bernardopg/ps28-modern-amp/kicad/core-oem-refined/README.md

# Candidata OEM refinada — STUDY ONLY

Estudo separado das revisões B/C, não aprovação mecânica/elétrica ou de fabricação.
Contorno153×79,1mm inferido do painel de cobre; escala vertical, borda real e mapa
completo de montagem não verificados. Reservas conservadoras9×9mm nas quatro
camadas, sem transformar features ambíguas em furos. J6 é bond GND por trança,
sem novo mounting point. Reutilizar somente fixações/suportes/dissipadores OEM.

47 footprints/142 pads; DRC nativo0 geometria/0 paridade/109 não roteadas;
ERC4 conflitos não excluídos. Ainda faltam fonte, controle, front-end e proteção.
Ver `docs/functional-readiness.md` e `tests/reports/core-oem-refined-review.json`.
O gerador recusa sobrescrever; não regenerar sobre projeto editado/roteado.
