bernardopg/ps28-modern-amp/kicad/core-oem/README.md

# OEM-referenced core C STUDY

Reconstructed scale/placement, NOT manufacturing approval.
Original B preserved. See ../../mechanical/original-board-reference.md and oem-reconstruction.json.
No inferred holes; ambiguous features reserved. Actual edge/right strip and vertical scale unresolved.
