bernardopg/ps28-modern-amp/kicad/core-selected/README.md

# Core B — seleção e placement

47 componentes/footprints; consultar ../../docs/selected-core.md.
Sem fit medido, sem roteamento e sem fabricação autorizada.
MPNs são seleção de engenharia, sem estoque/compra/lifecycle aprovados.
