bernardopg/ps28-modern-amp/docs/images/kicad-3d/README.md

# Renders KiCad

Vistas nativas de `kicad-cli pcb render` (KiCad 10, qualidade alta) da placa
`kicad/system-candidate/`. Pillow só aplica o fundo grafite e monta o GIF.
Para a apresentação de produto, ver os [renders Blender](../pcb-studio/README.md).

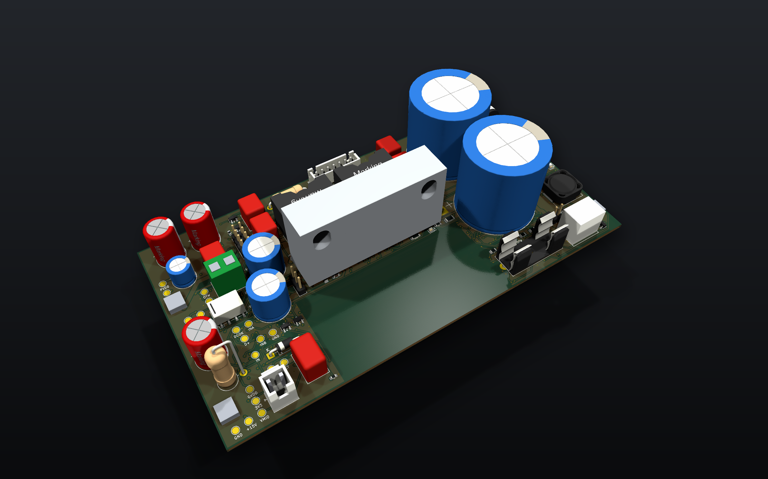
[picture p4: docs/images/kicad-3d/system-isometric.png]
Isométrica


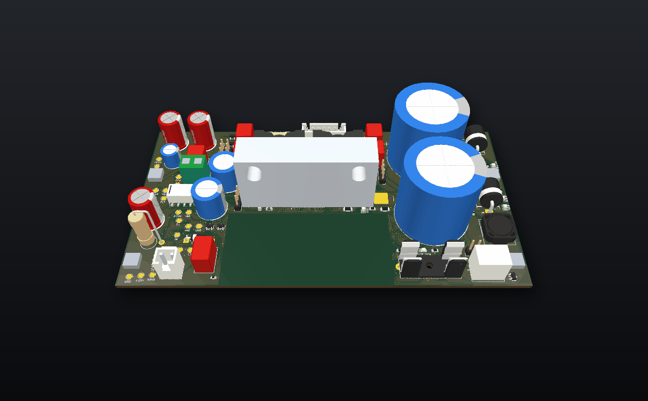
[picture p5: docs/images/kicad-3d/system-orbit.gif]
Órbita


| Topo | Verso |
|---|---|
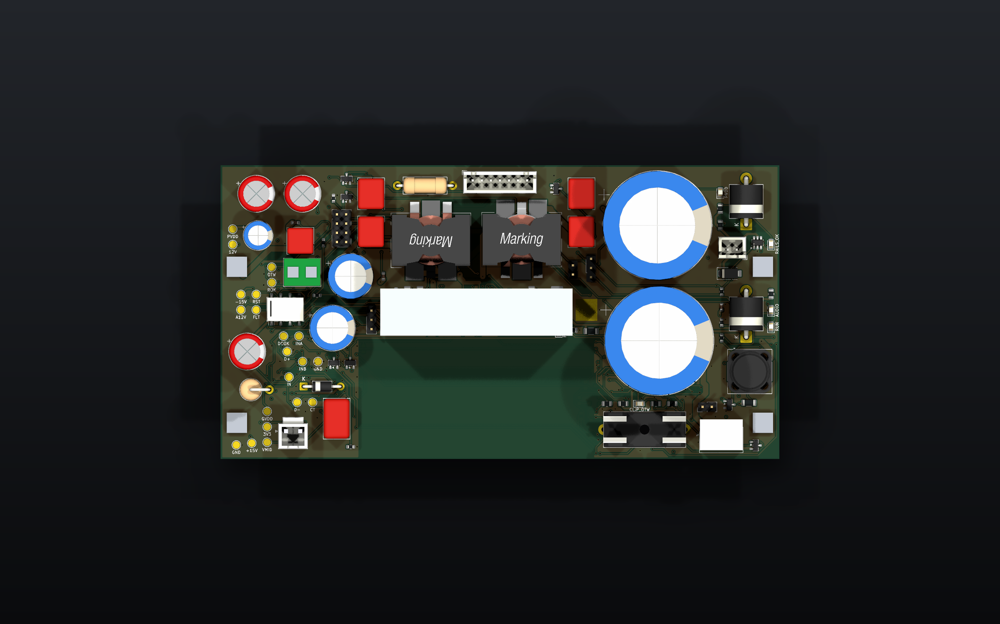
[picture p6: docs/images/kicad-3d/system-top.png]
Topo
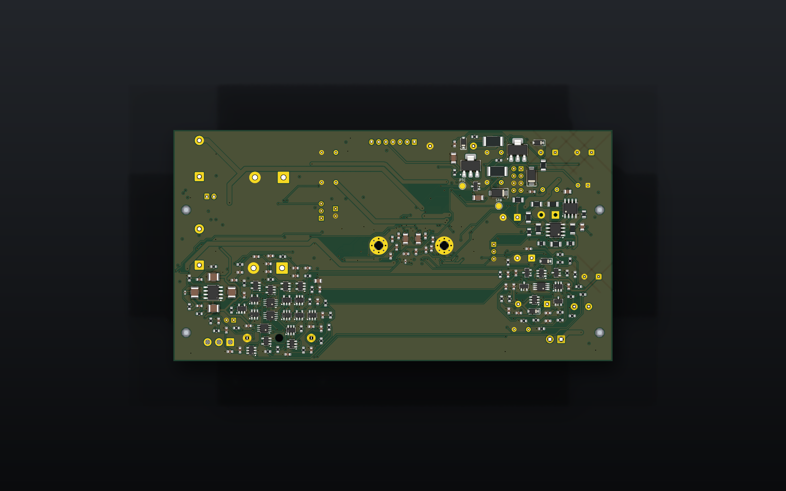
[picture p7: docs/images/kicad-3d/system-bottom.png]
Verso
|  |  |

Modelos de catálogo KiCad (cores genéricas). Sem modelo 3D: test pads, J6 e H6
(o bloco térmico usa o modelo de H5); lista no [manifesto](manifest.json).

Regenerar: `make render-3d`.
