bernardopg/ps28-modern-amp/docs/images/system-candidate/README.md

# Esquema da placa

[Esquema completo em SVG](system-candidate.svg), exportado do `.kicad_sch` de
`kicad/system-candidate/`. Estado de liberação em [status.md](../../status.md).

Regenerar:

```sh
kicad-cli sch export svg --output build/system-svg/ kicad/system-candidate/system-candidate.kicad_sch
```
