bernardopg/ps28-modern-amp/docs/images/.ps28-gallery-q9vnf0af/README.md

# Arquivo de renderização interrompida — não usar como galeria atual

Imagens parciais remanescentes de uma execução interrompida de 2026-10-13,
preservadas na consolidação de todo o diff a pedido do proprietário.
Não possuem manifesto completo dessa execução e não representam o estado
elétrico/mecânico atual. Não substituir os renders atuais por estes arquivos.

Galeria atual com manifesto: [../kicad-3d/README.md](../kicad-3d/README.md).
