bernardopg/ps28-modern-amp/docs/images/analog-protected/README.md

# Exportações nativas KiCad — D-018
PDF e SVG exportados por `kicad-cli sch export pdf` e
`kicad-cli sch export svg` de
`kicad/analog-protected/analog-protected.kicad_sch`.
32 componentes/80 pinos/ERC0, candidata sob envelope; não fabricação/energização.
Essas imagens NÃO são render3D nem PCB roteada. A galeria3D anterior permanece
válida para os mesmos arquivos de PCB, que não foram alterados.
Ver `docs/vmid-protection.md` para limitações físicas/power-order/interfaces.
