bernardopg/ps28-modern-amp/12_REFERENCES.md

# Referências oficiais e técnicas

## Texas Instruments

### TPA3255

- Product page: https://www.ti.com/product/TPA3255
- Part: https://www.ti.com/product/TPA3255/part-details/TPA3255DDVR

### TPA3255EVM

- EVM page: https://www.ti.com/tool/TPA3255EVM
- User guide: https://www.ti.com/lit/pdf/SLOU441
- Schematic Rev. A: https://www.ti.com/lit/df/slar129a/slar129a.pdf
- BOM Rev. A: https://www.ti.com/lit/df/slar130a/slar130a.pdf
- PCB Rev. A: disponível na página oficial da EVM.
- LC Filter Designer: disponível na página oficial da EVM.

## KiCad

- Site: https://www.kicad.org/
- KiCad 10.0.6 release: https://www.kicad.org/blog/2026/08/KiCad-10.0.6-Release/
- IPC API: https://dev-docs.kicad.org/en/apis-and-binding/ipc-api/

## IA / MCP

- KiCad AI Assistant: https://github.com/paul356/KiCad-AI-Assistant
- Konnect: https://github.com/obhox/kicad-mcp
- KiCad MCP Pro canonical project: https://github.com/oaslananka/kicad-mcp

## Fabricação

- JLCPCB PCBA pricing: https://jlcpcb.com/help/article/pcb-assembly-price
- JLCPCB new customer coupons: https://jlcpcb.com/help/article/new-customer-coupons

## Infinity PS28

Manter no repositório local:

- service manual original do PS28;
- fotos da placa original;
- medições do woofer e gabinete;
- dimensões da plate amp;
- pinagem/chicotes existentes.

A placa nova usa o manual antigo principalmente para requisitos funcionais e mecânicos; a arquitetura elétrica de potência será nova.
