bernardopg/ps28-modern-amp/.tasks/project-backlog.md

# Backlog

Estado canônico em `items/`; espelho GitHub em [github-mirror.json](github-mirror.json).
Atualizado em **2026-10-17**: 17 tasks, 12 Done, 1 In Progress, 4 To Do.

## Caminho até a placa funcionando

Tudo é trabalho de mesa, exceto MECH-002 (dimensional) e BENCH-002 (instalação), conforme D-037.

| Ordem | Task | Estado | Gate | Depende de |
|---|---|---|---|---|
| 1 | [PCB-002 — revisão global de layout](items/PCB-002.md) | In Progress | G2 | PCB-001 |
| 2 | [ELEC-003 — auditoria elétrica](items/ELEC-003.md) | To Do | G1 | ELEC-001 |
| 3 | [MECH-002 — gabarito 1:1 na unidade OEM](items/MECH-002.md) | To Do | — | MECH-001 |
| 4 | [FAB-001 — pacote, cotação e pedido](items/FAB-001.md) | To Do | G3 | PCB-002, ELEC-003, MECH-002 |
| 5 | [BENCH-002 — montagem e primeira energização](items/BENCH-002.md) | To Do | G4 | FAB-001 |

PCB-002, ELEC-003 e MECH-002 podem andar em paralelo (WIP máximo 2).

## Concluídas

[SETUP-001](items/SETUP-001.md) · [SETUP-002](items/SETUP-002.md) ·
[SETUP-003](items/SETUP-003.md) · [SYS-001](items/SYS-001.md) ·
[SYS-002](items/SYS-002.md) · [MECH-001](items/MECH-001.md) ·
[PWR-001](items/PWR-001.md) · [ELEC-001](items/ELEC-001.md) ·
[ELEC-002](items/ELEC-002.md) · [ELEC-004](items/ELEC-004.md) ·
[PCB-001](items/PCB-001.md) · [PCB-004](items/PCB-004.md)

Done = trabalho de projeto verificado; não é autorização de compra, fabricação ou energia.
