bernardopg/ps28-modern-amp/docs/assets.md

# Assets e proveniência

- Bibliotecas oficiais KiCad instaladas; preferir symbol/footprint oficiais e validar
  pin mapping, package drawing, PowerPAD/paste e STEP antes de usar.
- PDFs TI baixados e validados como PDF em reference/ti; URLs/hashes no manifesto.
  Não redistribuir automaticamente material de terceiros; downloads ignorados no Git.
- Manual PS28, fotos/chicotes, dimensões e modelo CAD: pendentes SYS-001/MECH-001.
- Modelo SPICE NE5532/DC/DC: obter do fabricante, registrar licença/versão e verificar
  compatibilidade com ngspice; converter só com comparação documentada.
- SnapEDA/Ultra Librarian podem ajudar, mas não são prova de footprint correto.

Para qualquer asset: URL, autor, revisão, data de acesso, SHA256, licença, uso e nível
de revisão. Evitar imagens decorativas e grandes assets sem função de engenharia.
