bernardopg/ps28-modern-amp/docs/procurement.md

# BOM e compras

BOM inicial é uma lista de candidatos em bom/README.md. BOM de montagem virá do
schematic; não criar refs/quantidades aparentemente definitivas agora.

Preferir TI/distribuidores autorizados para ICs e MPNs com datasheet para magnetics,
fonte/DC/DC. JLC/LCSC podem ser úteis para PCBA, mas verificar part ID, lote,
autenticidade, lifecycle, equivalência e estoque na data. Marketplace não é autoridade técnica.

Cotação deve registrar data/hora, país/CEP destino (solicitar sem publicar), moeda,
MPN/fabricante, fornecedor/link, quantidade/MOQ, estoque, lead time, unitário,
frete/impostos/câmbio, total landed, risco e validade. Campos desconhecidos ficam TBD.
Comparar ≥2 fornecedores equivalentes quando disponível; alternativa requer revisão
elétrica/térmica/mecânica. Melhor preço não justifica footprint/Isat/qualidade inferior.

Brasil é contexto provável, não destino confirmado. Incoterms e tributos precisam de
cotação atual; não calcular imposto com regra genérica desatualizada. Sem compra automática.
