bernardopg/ps28-modern-amp/docs/references.md

# Referências

Fontes TI baixadas em 2026-10-07; checksums em reference/manifest.json.
URL dinâmica pode entregar revisão nova: conferir capa e hash, não confiar no nome.

- [TPA3255 produto](https://www.ti.com/product/TPA3255).
- [Datasheet](https://www.ti.com/lit/ds/symlink/tpa3255.pdf): download SLASEA8A,
  revisão outubro/2016; §10.2.4, fig.31/tabela11 p.28 para PBTL.
- [TPA3255EVM](https://www.ti.com/tool/TPA3255EVM).
- [SLOU441](https://www.ti.com/lit/pdf/slou441): julho/2016; §4.2 p.10.
- [SLAR129A schematic](https://www.ti.com/lit/df/slar129a/slar129a.pdf).
- [SLAR130A BOM](https://www.ti.com/lit/df/slar130a/slar130a.pdf).
- [KiCad docs](https://docs.kicad.org/) e [IPC](https://dev-docs.kicad.org/en/apis-and-binding/ipc-api/).
- [NE5532 TI](https://www.ti.com/product/NE5532): datasheet/modelos ainda a revisar.
- [KiCad AI Assistant](https://github.com/paul356/KiCad-AI-Assistant).
- [Konnect](https://github.com/obhox/kicad-mcp).
- [MCP Pro](https://github.com/oaslananka/kicad-mcp-pro).

Manual de serviço Infinity PS28 recebido do proprietário: Rev1 3/2007, 25 páginas,
versão 120 V; cópia local em `reference/infinity/ps28-service-manual.pdf`, hash no manifesto.
Revisadas especificações/lista de peças e figuras de fonte/blocos/schematic.
Páginas impressas 16 e 24 identificam T1 e sua topologia, mas NÃO tensão VAC/potência VA.
Ver [decisão de reaproveitamento](transformer-reuse.md). Confirmar etiqueta/revisão
física e estado do transdutor; documentação não equivale à medição da unidade.
Links de plugins não são endosso de sign-off.
