bernardopg/ps28-modern-amp/.tasks/items/BENCH-002.md

---
id: BENCH-002
title: Montagem no gabinete e primeira energização
status: To Do
milestone: M4
sprint: S05
depends_on: FAB-001
updated: 2026-10-17
---
# BENCH-002 — Montagem no gabinete e primeira energização

## Objetivo

Montar a placa recebida no gabinete PS28 e ligar com segurança, sem ensaios de
bancada (D-037). Procedimento: [docs/bringup.md](../../docs/bringup.md).

## Critérios de aceite

- [ ] Dimensões de montagem: apoios H5/H6 iguais, folga superior real 0,05–0,10 mm com TIM, shim lateral ajustado, rosca OEM com engate
- [ ] Vínculo J6→bloco→perfil confirmado com multímetro; nenhum lead tocando o bloco
- [ ] Primeira energização com lâmpada-série, sem woofer: PVDD, AUX 12 V, 3V3 e ±15 V dentro de `docs/requirements.md`; LEDs RAILS_OK/RUN acesos; FAULT apagado
- [ ] Woofer conectado: som limpo em volume baixo e médio, sem estalo de liga/desliga
- [ ] Uso normal sem OTW/clip persistente; ok G4 do proprietário

## Evidência

Pendente.
