bernardopg/ps28-modern-amp/.tasks/items/FAB-001.md

---
id: FAB-001
title: Pacote de fabricação, cotação e G3
status: To Do
milestone: M3
sprint: S04
depends_on: PCB-002, ELEC-003, MECH-002
updated: 2026-10-17
---
# FAB-001 — Pacote de fabricação, cotação e G3

## Objetivo

Gerar o pacote JLCPCB (Gerber, BOM, CPL) da revisão aprovada, cotar com estoque
real e obter o "ok" G3 do proprietário. Inclui o antigo BUY-001.

## Critérios de aceite

- [x] Fabricante/MPN definidos para as 235 posições de compra
- [ ] Códigos LCSC/estoque e lifecycle conferidos; itens THT/manuais separados
- [ ] CPL com rotação conferida no visualizador JLCPCB
- [ ] Pacote por tag/checksum e cotação datada (placa + montagem + frete)
- [ ] G3 assinado pelo proprietário

## Evidência

[Fechamento das 235 posições](../../docs/bom-closeout-2026-10-16.md);
`make fab` gera rascunho com hashes em `build/fab/drafts/`. Nada enviado ou comprado.
