bernardopg/ps28-modern-amp/.tasks/items/SYS-002.md

---
id: SYS-002
title: Fechar requisitos e limites de aceitação
status: Done
milestone: M1
sprint: S02
depends_on: SYS-001
updated: 2026-10-17
---

# SYS-002 — Fechar requisitos e limites de aceitação

## Objetivo

Fechar requisitos e limites de aceitação, atendendo docs/requirements.md e gates docs/safety.md.

## Critérios de aceite

- [x] Potência, frequência, THD, duração, ambiente e excursão especificados
- [x] Baseline e G0 aprovados pelo proprietário

## Evidência

Requisitos Rev.B, docs/sys002-baseline.md, tests/acceptance.md (bench-plan substituído por D-037).
Relatório tests/reports/sys002-capacitors-2026-10-17.json:146 testes;
ERC/DRC/paridade/aberturas0;48 capacitores revistos; C401/C403 corrigidos.
Baseline aprovada: `6cf2260da231e5125bdf267e938a8d7b2d3235dc`; registro em
`tests/reports/g0-revb-approval-2026-10-17.json`.
G0 Rev.B aprovado em2026-10-17: “Aprovo o G0 da Rev.B”. Execução física pertence
a BENCH-002/ACOU-001. Revisão dos capacitores em docs/capacitor-derating.md.

## Risco / aprovação

Alterações de hardware exigem fonte primária e gate humano; sem pedidos automáticos.
