bernardopg/ps28-modern-amp/.tasks/sprints/S03.md

# S03 — Schematic e front-end real validados G1

Concluída. Tasks e evidências nos itens Done do [backlog](../project-backlog.md);
log detalhado no histórico Git.
