bernardopg/ps28-modern-amp/.tasks/sprints/S04.md

# S04 — Layout e fabricação (G1/G2/G3)

Status: ativa. WIP ≤ 2.

## Tasks

- [PCB-002](../items/PCB-002.md) — revisão global de layout, G2
- [ELEC-003](../items/ELEC-003.md) — auditoria elétrica, G1
- [MECH-002](../items/MECH-002.md) — gabarito 1:1
- [FAB-001](../items/FAB-001.md) — pacote, cotação, G3

## Log

- 2026-10-17: replanejamento D-037/D-038. Bancada substituída por análise; tasks
  BUY-001→FAB-001, BENCH-001/ACOU-001→BENCH-002, TOOL-001 e PCB-003 removidas.
  Revisões antigas removidas do repositório; renders refeitos.
- 2026-10-16: PCB-001 Done; BOM com 235 posições resolvidas; ERC/DRC/paridade 0.
