bernardopg/ps28-modern-amp/.tasks/items/PCB-001.md

---
id: PCB-001
title: Stackup, placement e térmica
status: Done
milestone: M3
sprint: S04
depends_on: MECH-001
updated: 2026-10-16
---

# PCB-001 — Stackup, placement e térmica

## Objetivo

Stackup, placement e térmica, atendendo docs/requirements.md e gates docs/safety.md.

## Critérios de aceite

- [x] Stackup fabril e cobre/vias justificados
- [x] Loops/LC/PowerPAD/dissipador/fit comparados com baseline

## Evidência

2026-10-16: fit local térmico revisto em `mechanical/thermal-block.md` e
`tests/reports/thermal-fit-review.json`. Corrigidos altura dos furos OEM (23,65 mm),
transformação do WRL, área do pedestal e montagem com batentes independentes do CI.
CAD nominal/tolerâncias e malha testados; R junção→perfil calculado 2,25…3,97 °C/W,
caminho OEM→ambiente não medido. Não comprova 150 W contínuos nem G2 físico/térmico.
Cobre/posições de footprints preservados. Confirmar calços, folgas, rosca e perdas
na montagem/BENCH-002; stackup de fabricação continua sujeito à cotação FAB-001.

2026-10-13 (D-031/D-033): placement por zonas revisado (LC junto ao U1, buck sob L301,
retificador do lado de T1, bloco térmico); 4 camadas com planos GND (In1) e PVDD (In2)
e fills GND; tabela em `docs/pcb-layout.md`. Stackup de fábrica padrão 1,6 mm/1 oz
confirmado na cotação (FAB-001).

2026-10-12 (D-031): placement de estudo no contorno OEM com keepout do bloco térmico; só SMD baixo sob o bloco; C14/C15 D12,5; J5 VH; J6 para trança GND. ERC 0, DRC 0, paridade 0. Falta revisão manual do placement de potência/Classe D e stackup.

2026-10-10: candidata de sistema com mecânica OEM **medida** (MECH-001): contorno
154 × 81 mm, 4 furos M3 board-only (10/53 mm do backplate, 4,5 mm das bordas) e
área proibida do perfil U em F.Cu (65 × 33 mm, 38 mm da borda superior). Gerado por
`integrate_candidate.oem_mechanics()` a partir de `mechanical/oem-heatsink-measurements.json`.
Orientação confirmada pelo proprietário: borda superior (x = 20) = lado do relé OEM,
inferior (x = 174) = lado do transformador; perfil U encostado na placa e no backplate.
Placement de estudo (`scripts/place_system_candidate.py`): todos os 204 componentes
dentro do contorno; potência/THT no topo, lógica e analógico SMD no fundo; TPA3255
junto da perna do perfil. DRC: 0 sobreposição, 0 curto, 0 violação de keepout; 105
avisos de silkscreen; 470 conexões sem rota. Não é layout revisado (loops, GND, térmica).

Pendente. Não marcar critérios sem evidência.

## Risco / aprovação

Alterações de hardware exigem fonte primária e gate humano; sem pedidos automáticos.
