bernardopg/ps28-modern-amp/.tasks/items/PCB-004.md

---
id: PCB-004
title: Test points, LEDs de status/debug e conector de fan
status: Done
milestone: M3
sprint: S04
depends_on: PCB-001
updated: 2026-10-13
---

# PCB-004 — Test points, LEDs de status/debug e conector de fan

## Objetivo

Pedido do proprietário (2026-10-12): poder medir os pontos importantes com as pontas
do multímetro/osciloscópio, ver o estado lógico da placa por LEDs e ter onde ligar
uma fan se a térmica pedir. Entra antes da rota final (mexe no placement).

## Critérios de aceite

- [x] Test points (pad Ø2 mm ou laço para garra) com rótulo no silk:
  GND (2+, um em cada ponta da placa), PVDD, AUX_RAW, P15V, N15V, ANALOG_12V, VMID,
  SEQ_3V3, GVDD, RESET, FAULT, CLIP_OTW, RAILS_OK, DC_OK, PRE_IN, DIFF_P/DIFF_N,
  INPUT_A_AC/INPUT_B_AC, T1_CT. SPK+/SPK− só no J5, marcados "NÃO É GND".
- [x] LEDs SMD 0805 com resistor, alimentados de AUX_RAW/SEQ_3V3 por transistor
  (não carregar pinos do TPA nem nós analógicos): PVDD presente, AUX/RAILS_OK,
  RESET liberado (RUN), FAULT, CLIP_OTW, relé K501 fechado (áudio ligado).
- [x] Conector de fan 2 vias (JST XH) em 12 V (AUX_RAW), chaveado por MOSFET SOT-23
  com diodo de roda livre; acionamento por jumper (sempre ligada) ou pelo CLIP_OTW
  (liga em aviso térmico). Orçamento de corrente do buck LM5164 conferido.
- [x] ERC 0, DRC 0, paridade 0 depois da inclusão; placa re-roteada.

## Evidência

2026-10-13: `scripts/create_debug_io.py`, grupo `dbg` da placa única (46 peças, todas
no lado dos componentes).
- 21 test points TP110–TP130 (dois GND), nome da rede no silk; SPK± fora.
- LEDs D701–D706: PVDD (47 k direto do bulk, mostra carga residual), RAILS_OK, RUN
  (RESET alto), AUDIO (K501 fechado, em série no RELAY_DRV), FAULT e CLIP_OTW
  (inversor BSS138 com pull-up a 3V3 + driver). Só gates de MOSFET nos nós de status.
- Fan: J8 JST XH 2 vias 12 V ≤ 200 mA, Q707 AO3400A, flyback S1M, JP701 1-2 sempre
  ligada / 2-3 liga com CLIP_OTW (clip ou aviso térmico); sem jumper fica desligada.
- ERC 0, DRC 0, paridade 0 antes da rota; placa re-roteada (ver PCB-002).

## Risco / aprovação

SPK± são ativos: nunca usar como referência de ponta de prova. LEDs e fan não podem
mudar sequenciamento nem carregar VMID/INPUT. Fan só se BENCH-002 mostrar necessidade.
