bernardopg/ps28-modern-amp/.tasks/items/PCB-003.md

---
id: PCB-003
title: Spike de captura e placement do núcleo PBTL
status: Done
milestone: M2
sprint: S03
depends_on: SETUP-002
updated: 2026-10-12
---
# PCB-003 — Primeiro incremento EDA

## Objetivo
Iniciar core TPA3255 usando aplicação TI completa, sem aguardar escolha de peças
que dependem de medidas da fonte. Spike exploratório não fecha ELEC-003/PCB-001,
não elimina suas dependências físicas nem aprova gates de projeto.

## Critérios de aceite
- [x] Captura inicial com pinout/mode PBTL, bootstrap, bypass/LC e interfaces rastreáveis.
- [x] Footprint DDV TopEP correto e primeiro placement com nets derivadas da captura.
- [x] Conectividade de schematic e 116 pads validada; ERC/DRC registrados sem suprimir pendências.
- [x] Revisão independente do incremento e seleção de MPNs/footprints críticos encaminhadas.

## Revisão B — seleção e placement
- [x] Todos 12 footprints críticos preenchidos; 47 footprints/142 pads conferidos.
- [x] MPNs/fontes/land patterns rastreados, sem alegar estoque/compra/lifecycle aprovados.
- [x] Silk/courtyard/paridade revisados: zero ocorrências geométricas/paridade no DRC.
- [x] Quatro faltas de fonte bootstrap resolvidas; quatro conflitos PBTL/aliases classificados.
- [ ] Revisão independente para aceitar exclusões individuais ERC; nenhuma exclusão aplicada.
- [ ] Roteamento: 109 conexões permanecem reais e não roteadas.
- [ ] Fit no plate/dissipador original: bloqueado por medidas de MECH-001.
Ver docs/selected-core.md e tests/reports/core-selected-review.json.

## Candidata OEM refinada — estudo preservando B/C
- [x] Candidata separada `kicad/core-oem-refined`,47 footprints/142 pads conferidos.
- [x] Reservas mecânicas em todas quatro camadas, sem furos presumidos.
- [x] DRC nativo:0 geometria/0 paridade/109 não roteadas; ERC4 conflitos sem exclusão.
- [x] Corrigida frequência LC e conferida resposta linear SPICE/analítica em201 pontos.
- [x]20 testes automatizados passaram; gerador atômico e validação explícita por diretório.
- [ ] Fonte/supervisor/front-end/limitação/proteção ainda não capturados no core.
- [ ] Revisão independente, roteamento, fit e gates físicos continuam pendentes.
Ver `docs/functional-readiness.md` e `tests/reports/core-oem-refined-review.json`.
Revisão atual em kicad/core-selected; draft A preservado para não sobrescrever GUI aberta.

## Atualização documental/3D — D-018/D-019
- [x] Galeria nativa regenerada: seis PNGs e dois GIFs de 16 câmeras KiCad cada;
  hashes de PCB/mídia/gerador e contexto elétrico conferidos, ausências 3D explícitas.
- [x] README/arquitetura/estado/layout/tasks distinguem core com placement de
  schematic D-018 sem PCB e contrato D-019 sem implementação.
- [ ] Integração do preamp/fonte/control/proteção no schematic/PCB completa.
B/OEM não mudaram de geometria: 47 footprints/142 pads, 109 conexões não roteadas,
quatro ERC não excluídos. D-018 tem 32 componentes/80 pinos e 13 footprints pendentes;
D-019 requer isolamento/mute/pré-carga qualificados. Renders não aprovam fit/G2.
Ver `docs/development-status.md` e `docs/images/kicad-3d/manifest.json`.
Status In Progress preservado; revisão independente continua pendente.
Espelho GitHub criado: issue19 (`.tasks/github-mirror.json`), sem duplicar task/WIP.
Checks nativos e mídia: `tests/reports/documentation-media-refresh.json`.

## Incremento D-021/D-023/D-024/D-024a (2026-10-09/10)
- [x] Candidata com fonte, sequenciador e interface D-019: 204 footprints, 580
  pinos casados netlist↔PCB, ERC igual à base, DRC 0 violações/0 footprint.
- [x] Footprints auditados contra fabricante: TI DGK0008A (SCDS420E p.50, local),
  Omron G6K-2F (K106-E1-11 p.6: 0,8×1,8 mm, passo 2,54, fileiras 7 mm).
- [ ] 118 footprints novos fora do contorno; placement OEM e roteamento (470 conexões).
Galeria 3D com vista `system-*`; ver `docs/development-status.md`.

## Incremento D-020 — candidato separado
`kicad/system-candidate/`:76 footprints/212 pads,29 em banco de importação
FORA do contornoOEM, não placement/fit. Núcleo anterior preservado; ponte de
sinal aberta, nenhuma proteção física disfarçada. CAD Würth CC para C1/L1/L2/
C201/C202; pads/tab semnet preservados. Footprints passivos candidatos, pulso/
ESR/temperatura/courtyards e proteção/supervisor/funções restantes pendentes.
Ver `docs/integration-protection-review.md`. In Progress sem fechamento de G2.

## Evidência histórica A
Ver docs/core-draft.md, kicad/core-manifest.json e scripts/check_core.py.
47 componentes, 35 footprints presentes, 12 não selecionados; 11 testes aprovados.
ERC 8 erros a revisar; DRC 85 não roteadas/12 footprints ausentes. Não liberado.
Snapshot anterior 20261007_143646_693300; branch feat/pbtl-core-draft.

## Risco / aprovação
D-011 usa SLASEA8A fig.31, não EVM híbrida. Outline e dissipador provisórios.
G0–G5 pendentes; a delegação para iniciar desenvolvimento não aprova fabricação.

## Rev A de bancada — D-029 (2026-10-12, revogada por D-030; pasta removida)
- [x] `kicad/rev-a-bench/` gerado por `scripts/create_rev_a_bench.py`: 198 footprints,
  567 pads netlist↔PCB, PVDD via J1, bloco T1 adiado (sem cobre reservado).
- [x] ERC igual à candidata (4 pin_to_pin PBTL, MONO_BIASED isolado); DRC 0 geometria,
  0 paridade; 460 conexões não roteadas. `tests/reports/rev-a-bench-review.json`.
- [ ] Corrigir ERC PBTL/MONO_IN (ver branch `fix/pcb-route-drc-erc`), ELEC-004, placement
  manual de potência/Classe D e roteamento manual (PCB-001/PCB-002).

## Evidência

2026-10-12 (D-030): spike concluído e absorvido pela placa única `kicad/system-candidate/`: 205 footprints no contorno OEM, ERC 0, DRC 0, paridade 0. Rota manual segue em PCB-002.
