bernardopg/ps28-modern-amp/.tasks/items/PWR-001.md

---
id: PWR-001
title: Selecionar fonte e proteção
status: Done
milestone: M1
sprint: S02
depends_on: SYS-001
updated: 2026-10-12
---

# PWR-001 — Selecionar fonte e proteção

## Objetivo

Selecionar fonte e proteção, atendendo docs/requirements.md e gates docs/safety.md.

## Critérios de aceite

- [x] T1 original qualificado (identidade, isolamento, VAC, envelope sob carga e térmica) ou alternativa descartada com evidência
- [x] MPNs fonte/DC-DC e datasheets rastreados
- [x] Tolerância/transientes/inrush/fusível/TVS/reversa e orçamento analisados

## Evidência

2026-10-12 (D-030): J301 B3P-VH, D301/D302 P600J, C301/C302 63USC4700 D30, F301 02186.3MXP, OVP por janela TPS3700 + SMCJ51A. Referência: placa original (manual PS28 p.14) e simulação D-021. Confirmação de fusível/temperatura na energização controlada (BENCH-002).

D-029 (2026-10-12): Rev A recebe PVDD de fonte de bancada por J1; J301/F301/D301/
D302/C301/C302 ficam para a Rev B após BENCH-001 medir inrush/I²t de T1. Desenho
mecânico TO-220AC do RHRP1560 ausente no datasheet arquivado (Rev.3 só tem foto:
flange = catodo); download onsemi negado em 2026-10-12. D-029 revogada por D-030.

Continuação de 2026-10-11: alternativas RHRP1560 (600 V/15 A/IFSM 200 A)
e LGU2A472MELC (4700 µF/100 V/105 °C/4,14 A) em captura separada
`kicad/power-researched/`; ERC 0, bulk com footprint de estudo pitch10/drill2.
54 casos D-021 reanalisados: CT até 8,014 A RMS e 63,640 A²s/100ms; banco
até 7,000 A RMS. LM5069 OVLO interno reprovado por tolerância. Proposta D-028,
fontes e limitações em `docs/power-remediation.md`. `make check`: 118 testes.
Não fecha task: footprint/térmica dos diodos, fit/partilha do bulk, fusível,
header e circuito OVP série/SOA ainda pendentes. Cobre anterior preservado.

Revisão de fonte primária (2026-10-11): **MUR3040WTG reprovado** contra
IFSM≥200 A: onsemi MUR3020WT/D Rev.7 p.2 informa 150 A (200 A é do MUR3020WTG).
Captura separada `kicad/power-package-review/` remove seleção falsa de diodos,
footprints incompatíveis de bulk/header e valor não qualificado do fusível,
preservando todas as nets D-021. `scripts/create_power_package_review.py`
reproduz sem sobrescrever diretório existente. ERC nativo: 0 violações;
`make check`: 111 testes. É captura incompleta com footprints pendentes,
não substitui sistema roteado e não autoriza placement/fabricação.

D-021 (2026-10-09): T1 medido 34,35 VAC/metade a 126,6 VAC; PVDD não regulado por
CT dois diodos. `make simulate-power`: 54 casos, máximo 49,84 V, bulk ≥10 mF,
PIV ≥102 V; captura `kicad/power-d021/` ERC0. Buck 12 V LM5164 (exemplo TI
SNVSAU4D Fig 7-1) e janela TPS3700 (OV 50,97–52,24 V, UV 27,3–28,4 V pior caso)
capturados; datasheets em `reference/ti/`. Footprints, MPNs de potência e inrush
TBD. Ver docs/power-d021.md. Critérios abaixo seguem abertos.

2026-10-10: footprints candidatos atribuídos e integrados à candidata (DRC 0);
janela de AUX_RAW (D-024) independente do PGOOD. Faltam: MPN de diodos/bulk/TVS/
fusível (requisitos em power-d021.md), inrush medido, regulação de T1 sob carga.

Manual PS28 Rev1 3/2007, p.16/p.24: T1 EI-86 120 V/60 Hz, secundário CT,
D110 KBL405 e C121/C122 6800 µF/50 V. Tensão VAC/corrente/VA não especificadas.
D-010 seleciona T1 reaproveitado + fonte secundária nova com alvo 36 V/12 V,
sem conexão direta de ±Vcc. Proprietário informa T1/capacitores saudáveis e capacidade
para ensaios; VAC/VA, ripple, corrente e térmica ainda dependem de medições.
Ver docs/transformer-reuse.md. Nenhum critério concluído sem medições/revisão.

D-018 acrescenta ramo analógico isolado de AUX12V:15Ω,2×470µF e bleeds;
consumo inclui até50mA ativos/fuga +divisor150/150Ω +bleed2,2k. Validar
carga/inrush/rail≥8V, ESR combinado≤0,5Ω e capacitância≥752µF na temperatura;
R201 exige curva de pulso/repetição, D201 Vf/fuga/térmica. Não pressupor que
AUX saudável é medido. TPA mantém AUX_RAW; power-order dos seus pinos de entrada
com preamp sustentado ainda bloqueia energização/integrar ao núcleo.

D-019: contraprovas RC e duas redes com a alimentação passiva D-018 mostram,
sob hipóteses explícitas de entrada/driver, por que VMID protegido não qualifica
INPUT_A/B quando o preamp sobrevive ao TPA. Isolamento/mute/pré-carga ainda TBD;
ANALOG_12V não pode alimentar VDD/GVDD TPA. Galeria regenerada só do core, sem
inserir fonte/preamp/proteção novos. Ver `docs/development-status.md`.
Status To Do e requisitos de medição/qualificação preservados.

D-020: passivos da candidata core+analógico receberam footprints/MPNs de triagem,
sem alterar D-018 histórico. R201 AC03 15 Ω /5% não fecha pulso/drift total5%;
I0≈0,926 A,E≈0,09827 J calculados com1128 µF/13,2 V, não ensaio.
C203 WIMA1 µF eR202/R203 TNPW1206 ainda exigem ESR/temperatura/aging/derating.
AUX_RAW é12 Vregulado antes da reserva, **não** secundário cru de T1; conversor
não implementado. Fonte/transformador/supervisor continuam pendentes, task To Do.

2026-10-11 (PWR-001): pesquisa de MPNs de potência com fonte primária. Relatório
`tests/reports/power-pwr001-parts.json`; datasheets arquivados em `reference/parts/`
(MUR3020WT onsemi Rev.7, SMCJ51A Littelfuse, JST VH) com SHA256 no manifesto.
Decisões formais D-025/D-026/D-027 em `docs/decisions.md`. Schematic `power-d021` e
`system-candidate` regenerados; ERC power-d021 0 erro (2 warnings de interface).
- D301/D302 (diodos): **DECIDIDO MUR3040WTG** (D-025) — VRRM 400 V, IF(AV) 15 A
  @145 °C, IFSM 200 A. STTH8L06 reprovado (IFSM 120 A). Footprint TO-247/DPAK TBD.
- C301/C302 (bulk): **DECIDIDO Rubycon 63USC4700MEFCSN30X30** (D-025, LCSC
  C1498587) — 4700 µF/63 V, 3,49 A rms @120 Hz, Ø30×30. Lacuna anterior (sem
  4700 µF/63 V no acervo) resolvida por snap-in real. Footprint snap-in Ø30 a auditar.
- D303 (TVS): **DECIDIDO por arquitetura** (D-026) — Vc<69 V é inviável com TVS
  passivo de 51 V (SMCJ51A grampeia 82,4 V > 69 V abs max do TPA3255). Proteção
  sustentada pelo TPS3700 OV (50,97–52,24 V); SMCJ51A só absorve transiente rápido.
- F301 (fusível): **DECIDIDO time-lag** (D-027) — rating pela corrente de operação,
  não pelo inrush; I²t exato e ampere aconfirmar na bancada (BENCH-001). Família
  Littelfuse 218/892. Sem NTC/relé de bypass (descartados: perda do NTC a 3,9 A e
  relé 17×23 mm sem caber no placement OEM).
- J301/J302 (conector): JST **VH SVH-41T-P1.1** (20 AWG, 3,96 mm, 10 A); housing/
  header e nº de vias TBD (confirmar pinagem T1).
LCSC/estoque/preço/landed cost **não** verificados (não inventados). Footprints de
potência ainda a auditar antes de G3. Sem compra, fabricação ou energização. Gates
G0–G5 permanecem PENDENTES.

## Risco / aprovação

Alterações de hardware exigem fonte primária e gate humano; sem pedidos automáticos.
