bernardopg/ps28-modern-amp/reference/README.md

# Referências externas

make fetch-reference baixa apenas fontes TI permitidas, verifica PDF e atualiza
manifesto com URL final, SHA256 e timestamp. Consulte docs/references.md.
PDFs ficam locais e ignorados pelo Git; nenhuma licença de redistribuição foi presumida.
Adicionar Infinity/NE5532/modelos só após confirmar identidade e direitos de uso.
