bernardopg/ps28-modern-amp/.tasks/PLANNING.md

# Planejamento

Scrumban solo: WIP máximo 2, backlog ordenado por dependência, roadmap Agora/Depois.
WIP máximo 2, backlog ordenado por risco/dependência, roadmap Now/Next/Later.

Fonte de estado: task .tasks/items/AREA-NNN.md. project-backlog é índice ordenado,
não segunda cópia de status; sprint lista IDs e objetivo, não marca hardware aprovado.
Milestone→epic (prefixo da área)→task; sprint é timebox, não gate.

Frontmatter obrigatório: id, title, status (To Do/In Progress/Blocked/Done),
milestone, sprint (backlog se não alocada), depends_on (IDs ou none), updated.
Ready: objetivo claro e dependências não bloqueantes. Done (D-030): trabalho de projeto
feito e verificado (ERC/DRC/teste/medida, o que couber), CHANGELOG atualizado e issue
espelho fechada. Pendências de bancada migram para BENCH-002; "ok" do proprietário
registrado quando a task for gate (G0–G5). Não segurar task aberta por TBD resolvível
na primeira energização controlada.

Fim de sessão: atualizar task/log de sprint. Fim do sprint: review/retro e realocar
pendentes. Fim de milestone: evidência explícita e atualizar roadmap. GitHub issues
são espelho/discussão; atualizar task local para evitar divergência.
