bernardopg/ps28-modern-amp/.tasks/ROADMAP.md

# Roadmap

**Agora (S04):** revisão global de layout (PCB-002/G2), auditoria elétrica
(ELEC-003/G1) e gabarito 1:1 (MECH-002). Fecha em FAB-001: pacote JLCPCB,
cotação e "ok" G3 do proprietário.

**Depois (S05):** placa recebida, montagem no gabinete e primeira energização com
lâmpada-série e sem woofer (BENCH-002/G4). Sem ensaios de bancada (D-037).

## Milestones

- **M0/S01** infraestrutura · **M1/S02** requisitos, woofer, T1 e mecânica ·
  **M2/S03** captura e simulação · **M3/S04** layout e fabricação ·
  **M4/S05** instalação.

## Fora do escopo

DSP, PFFB, controle remoto ou nova revisão física (D-030: uma placa só).
