bernardopg/ps28-modern-amp/.tasks/sprints/S01.md

# S01 — Fundação reproduzível e revisão do setup

Concluída. Tasks e evidências nos itens Done do [backlog](../project-backlog.md);
log detalhado no histórico Git.
