bernardopg/ps28-modern-amp/.tasks/sprints/S02.md

# S02 — Viabilidade, requisitos físicos e segurança G0

Concluída. Tasks e evidências nos itens Done do [backlog](../project-backlog.md);
log detalhado no histórico Git.
