bernardopg/ps28-modern-amp/.tasks/sprints/S05.md

# S05 — Instalação (G4)

Status: planejada; começa quando a placa chegar.

## Tasks

- [BENCH-002](../items/BENCH-002.md) — montagem no gabinete e primeira energização
