bernardopg/ps28-modern-amp/.tasks/items/BENCH-001.md

---
id: BENCH-001
title: Inventariar bancada e aprovar limites
status: To Do
milestone: M1
sprint: S02
depends_on: SYS-002, ELEC-001
updated: 2026-10-12
---

# BENCH-001 — Inventariar bancada e aprovar limites

## Objetivo

Inventariar bancada e aprovar limites, atendendo docs/requirements.md e gates docs/safety.md.

## Critérios de aceite

- [ ] Instrumentos e carga/sonda/cooling confirmados
- [ ] tests/bench-plan.md sem limites TBD e revisão humana registrada

## Evidência

Pendente. Não marcar critérios sem evidência.

## Risco / aprovação

Alterações de hardware exigem fonte primária e gate humano; sem pedidos automáticos.
