bernardopg/ps28-modern-amp/.tasks/items/SYS-001.md

---
id: SYS-001
title: Identificar woofer e integridade
status: Done
milestone: M1
sprint: S02
depends_on: none
updated: 2026-10-12
---

# SYS-001 — Identificar woofer e integridade

## Objetivo

Identificar woofer e integridade, atendendo docs/requirements.md e gates docs/safety.md.

## Critérios de aceite

- [x] Manual/etiqueta/fotos identificam PS28 e transdutor
- [x] DCR e inspeção mecânica reais registrados sem energização

## Evidência

2026-10-12 (D-030): etiqueta 20PR10DAG-FW06-E, Re 4,4 Ω medido (= manual p.9), cone livre (commit e4df36b). Polaridade do fio + do woofer registrada em MECH-001.

2026-10-10: falha da unidade original informada pelo proprietário: Q108 (TO-3P de
saída) com encapsulamento estourado e R112 derretido; subwoofer parado. Re do woofer
medido 4,4 Ω (dentro do manual) e T1 com 34,35 VAC/metade simétricas após a falha.
Cone verificado pelo proprietário: excursão livre, sem raspagem (teste manual,
sem medida de T/S ou de potência). Woofer considerado reaproveitável para Rev A.

Identificação informada pelo proprietário: Subwoofer Ativo Infinity Primus PS28,
versão original de alimentação 120 V AC. Fonte: mensagem do proprietário nesta sessão.
Manual/etiqueta, identidade e impedância do transdutor, DCR e integridade ainda
pendentes. A tensão de rede original não especifica o rail DC do amplificador novo.
Não marcar critérios sem essas evidências.

## Risco / aprovação

Alterações de hardware exigem fonte primária e gate humano; sem pedidos automáticos.
