bernardopg/ps28-modern-amp/.tasks/items/BUY-001.md

---
id: BUY-001
title: Cotação preliminar e estratégia de suprimento
status: To Do
milestone: M1
sprint: S02
depends_on: PWR-001, ELEC-001
updated: 2026-10-07
---
# BUY-001 — Cotação preliminar e estratégia de suprimento
## Objetivo
Cotação preliminar e estratégia de suprimento, atendendo docs/requirements.md e gates docs/safety.md.
## Critérios de aceite
- [ ] Destino/quantidade/moeda definidos privadamente
- [ ] Duas cotações equivalentes e landed cost com desconhecidos explícitos
## Evidência
Pendente. Não marcar critérios sem evidência.
## Risco / aprovação
Alterações de hardware exigem fonte primária e gate humano; sem pedidos automáticos.
