bernardopg/ps28-modern-amp/docs/archive/chatgpt/MANIFEST.md

# Manifest

Este pacote contém somente documentação Markdown para iniciar o projeto `ps28-modern-amp`.

## Documentos principais

1. `00_README.md`
2. `01_REQUIREMENTS.md`
3. `02_ARCHITECTURE.md`
4. `03_SCHEMATIC_REV_A.md`
5. `04_BOM_REV_A.md`
6. `05_KICAD_ARCH_SETUP.md`
7. `06_AI_MCP_WORKFLOW.md`
8. `07_PCB_LAYOUT_RULES.md`
9. `08_SIMULATION_VALIDATION.md`
10. `09_MANUFACTURING_JLCPCB.md`
11. `10_BRINGUP_TEST_PLAN.md`
12. `11_SAFETY_RISKS.md`
13. `12_REFERENCES.md`
14. `13_DECISIONS_TBD.md`

## Skills

- `skills/reference_design_guardrails.md`
- `skills/schematic_review.md`
- `skills/class_d_layout_review.md`
- `skills/bom_dfm_review.md`
- `skills/bringup_review.md`
