bernardopg/ps28-modern-amp/docs/images/.ps28-gallery-q9vnf0af/selected-orbit.gif

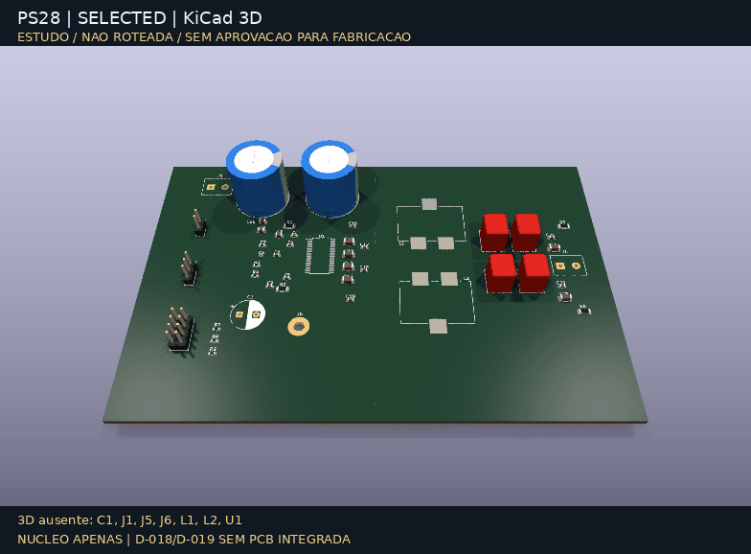
docs/images/.ps28-gallery-q9vnf0af/selected-orbit.gif
