bernardopg/ps28-modern-amp/docs/images/.ps28-gallery-q9vnf0af/selected-top.png

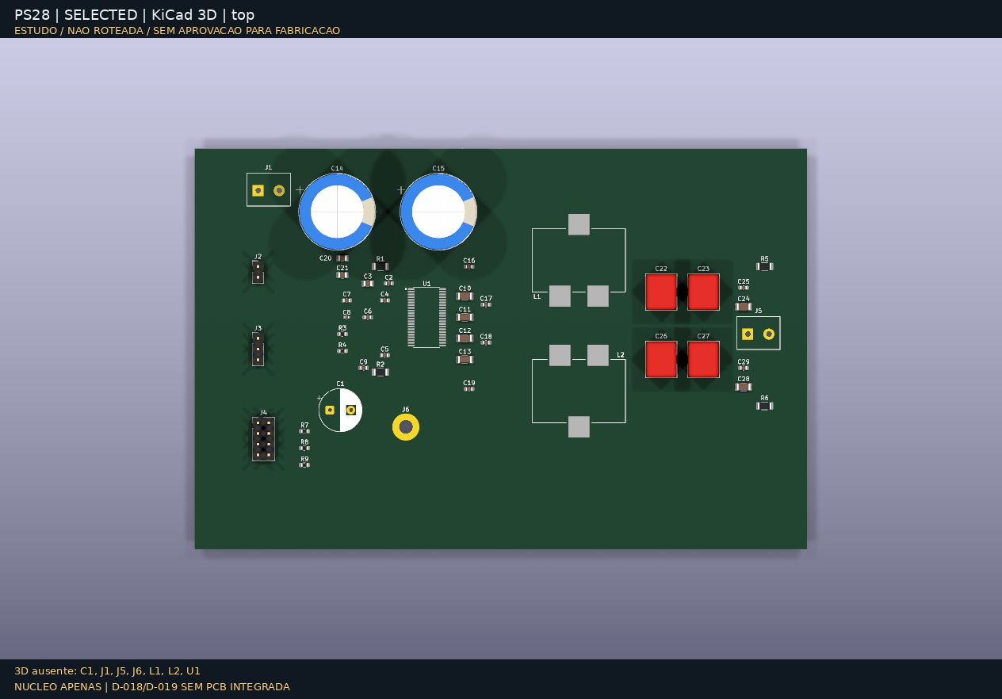
docs/images/.ps28-gallery-q9vnf0af/selected-top.png
