bernardopg/ps28-modern-amp/docs/images/kicad-3d/oem-bottom.png

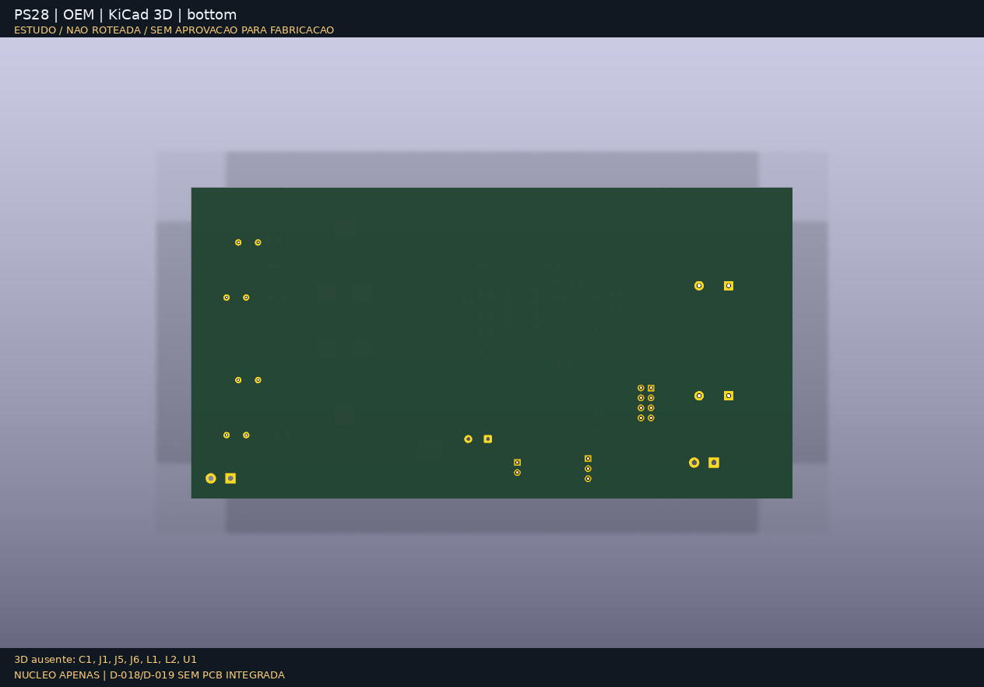
docs/images/kicad-3d/oem-bottom.png
