bernardopg/ps28-modern-amp/docs/images/kicad-3d/oem-isometric.png

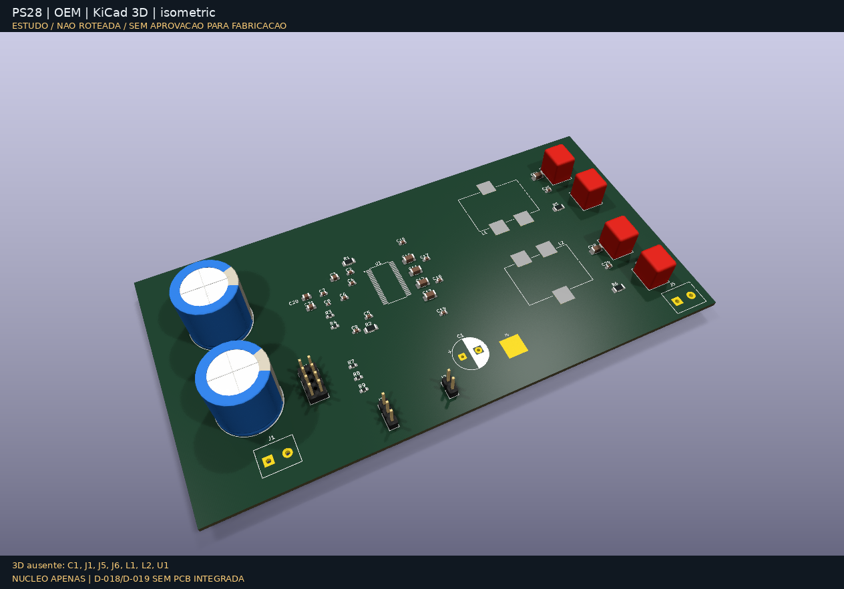
docs/images/kicad-3d/oem-isometric.png
