bernardopg/ps28-modern-amp/docs/images/kicad-3d/oem-orbit.gif

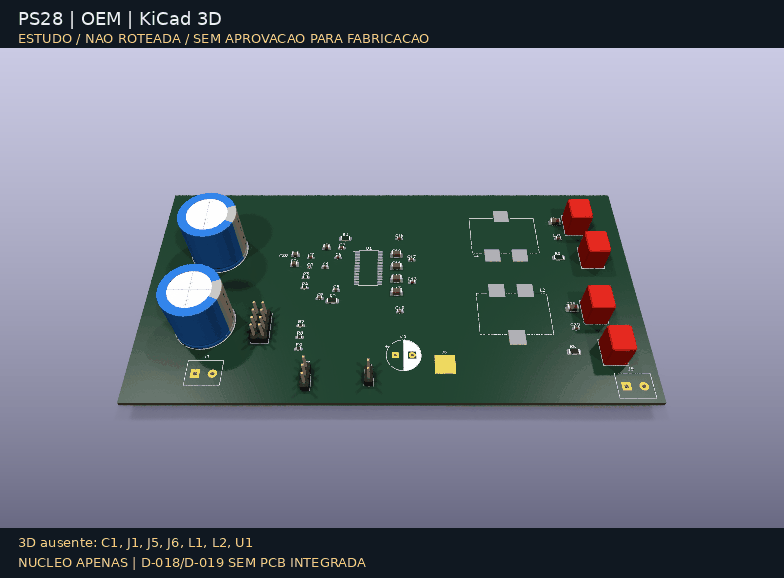
docs/images/kicad-3d/oem-orbit.gif
