bernardopg/ps28-modern-amp/docs/images/kicad-3d/oem-top.png

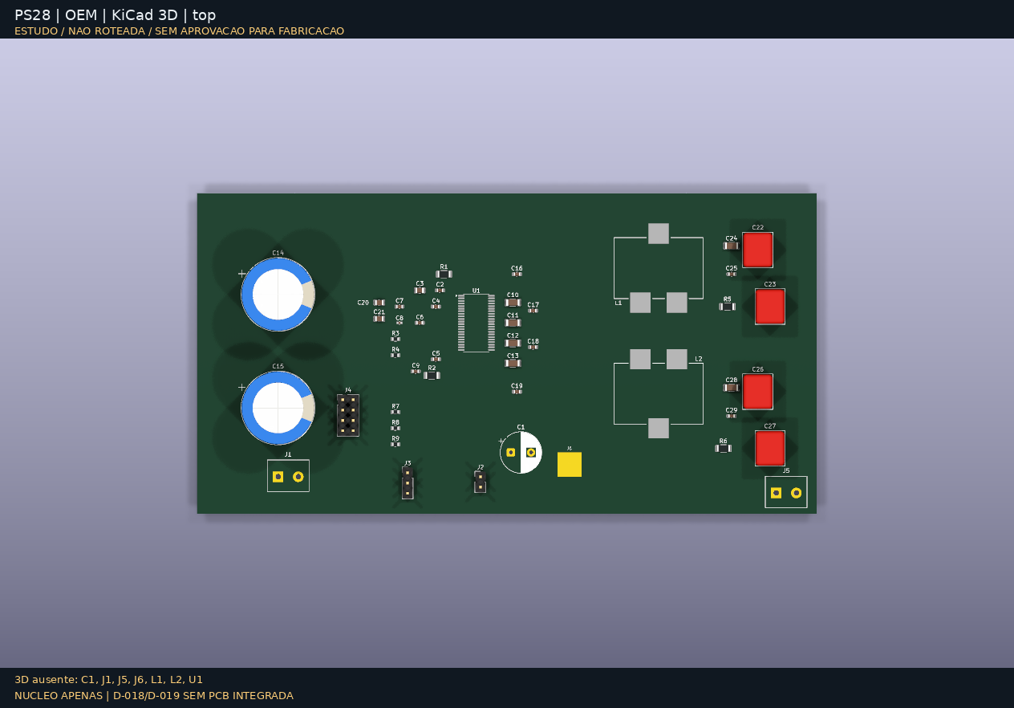
docs/images/kicad-3d/oem-top.png
