bernardopg/ps28-modern-amp/docs/images/kicad-3d/selected-bottom.png

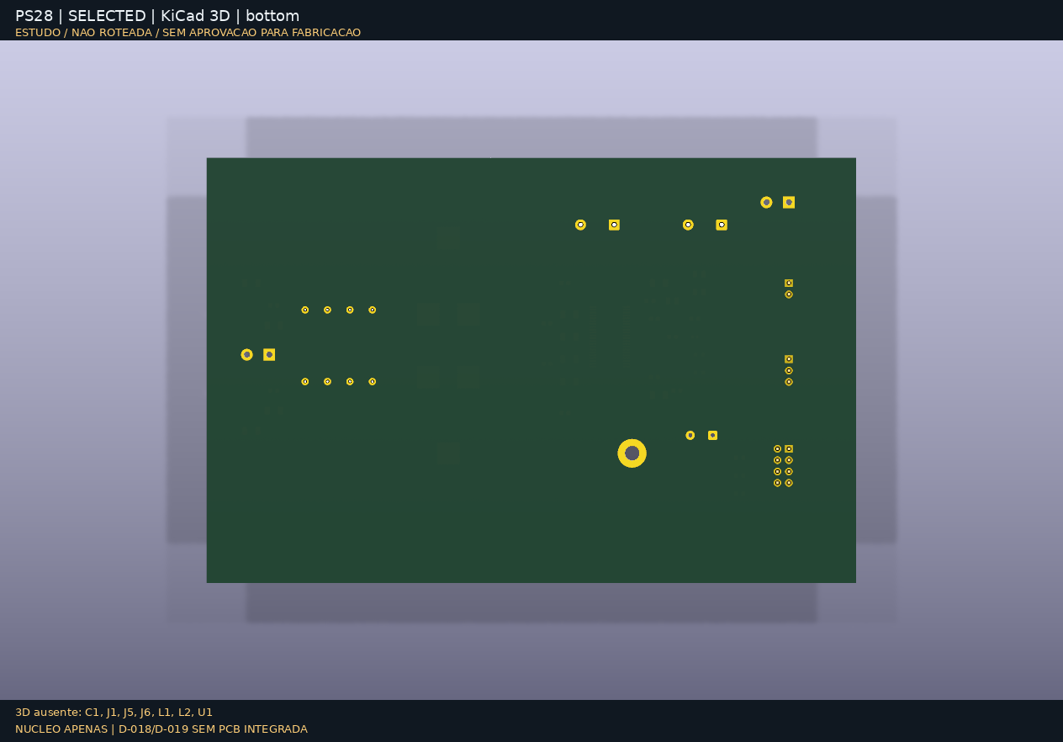
docs/images/kicad-3d/selected-bottom.png
