bernardopg/ps28-modern-amp/docs/images/kicad-3d/selected-isometric.png

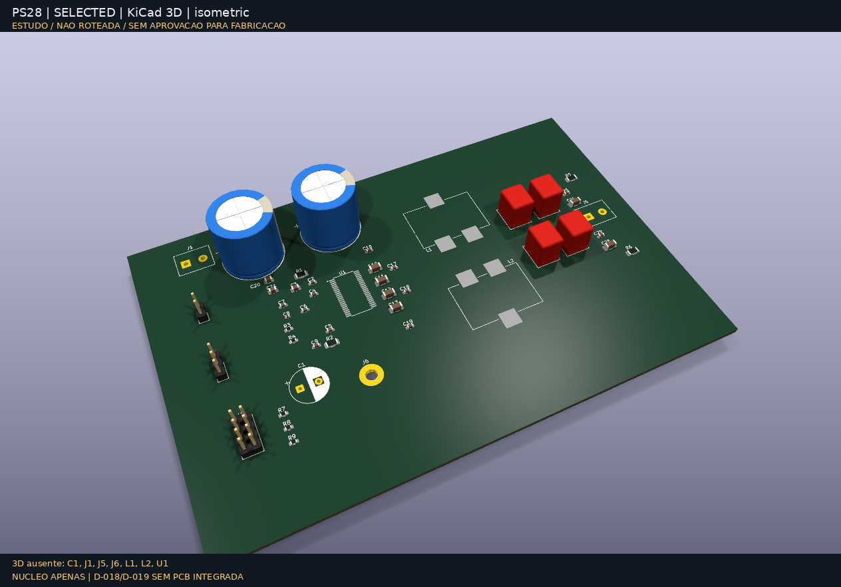
docs/images/kicad-3d/selected-isometric.png
