bernardopg/ps28-modern-amp/docs/images/system-candidate/core-with-vendor-cad.png

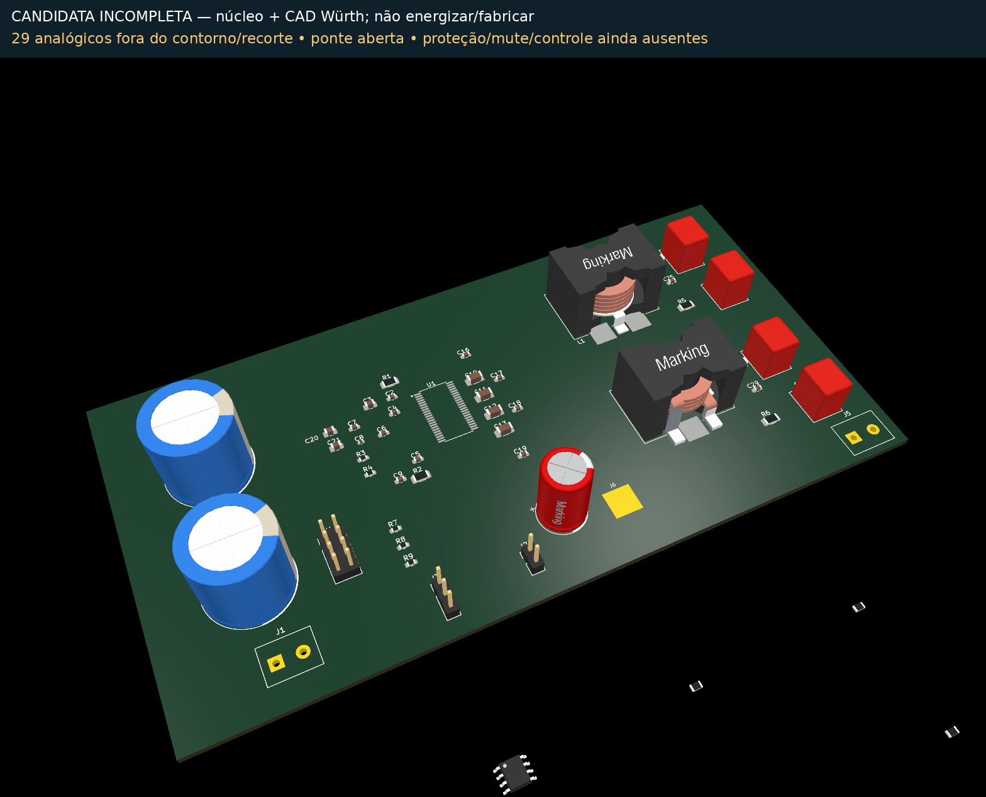
docs/images/system-candidate/core-with-vendor-cad.png
