bernardopg/ps28-modern-amp/docs/images/thermal-block-bottom.png

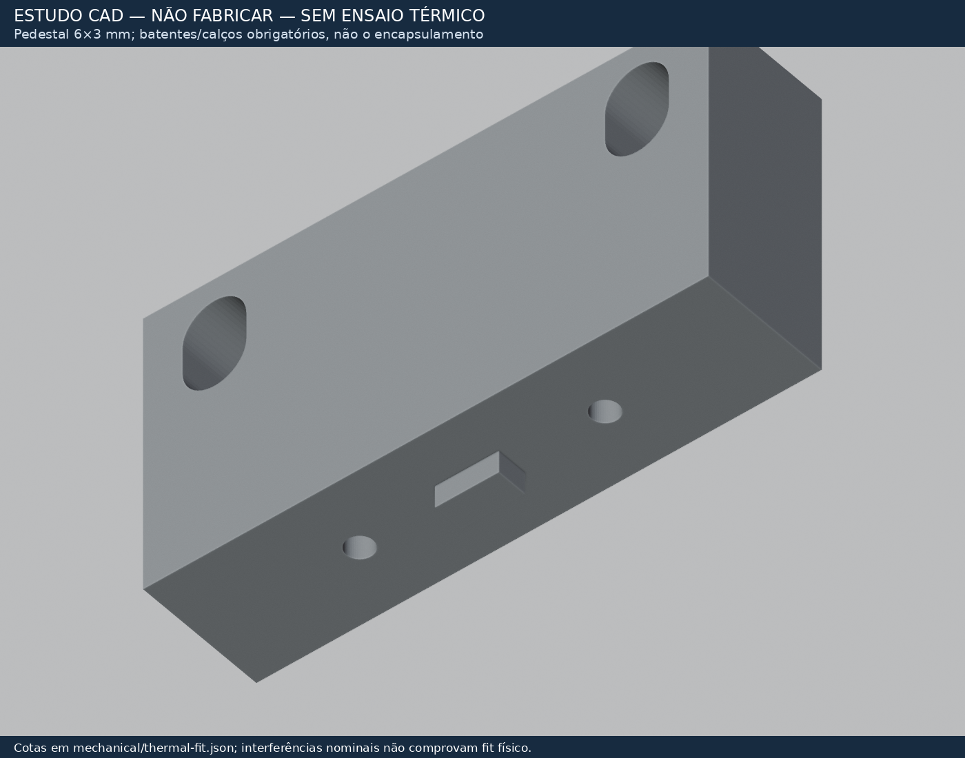
docs/images/thermal-block-bottom.png
