bernardopg/ps28-modern-amp/docs/images/thermal-block.png

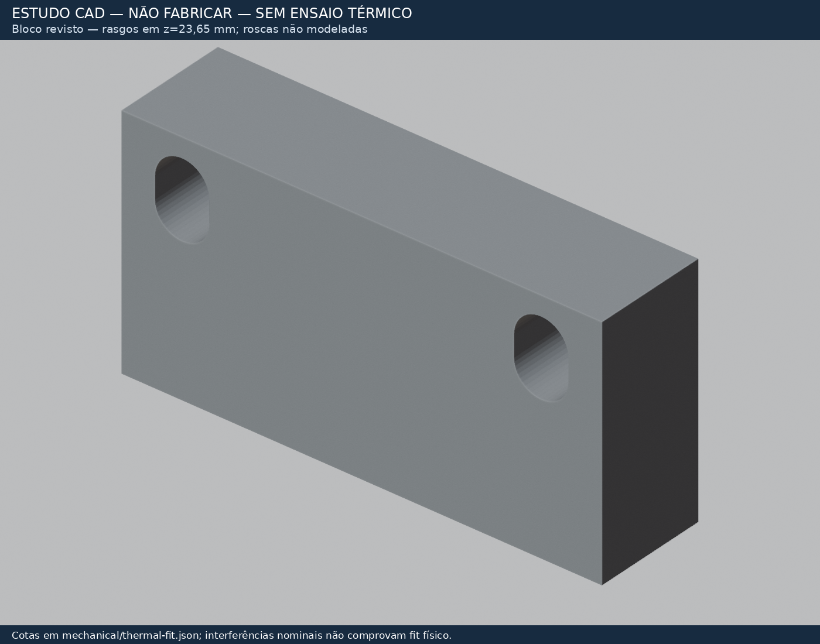
docs/images/thermal-block.png
