bernardopg/ps28-modern-amp/docs/images/thermal-fit-section.png

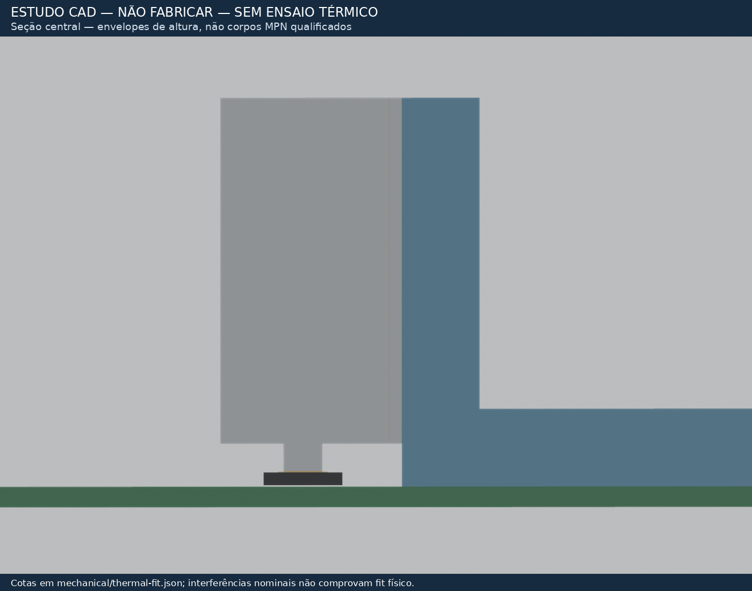
docs/images/thermal-fit-section.png
