bernardopg/ps28-modern-amp/skills/bom_dfm_review.md

# Skill — BOM / DFM Review

1. Verificar voltage/current/temperature ratings.
2. Conferir footprints contra datasheet.
3. Conferir disponibilidade JLCPCB/LCSC.
4. Identificar Basic versus Extended sem sacrificar componente crítico.
5. Marcar itens para montagem manual.
6. Conferir polaridade/orientação no CPL.
7. Conferir DNP.
8. Conferir se revisão da BOM corresponde à tag Git.

Nunca substituir indutor, capacitor do filtro LC, bootstrap, bulk ou op-amp crítico apenas por menor preço sem análise.
