bernardopg/ps28-modern-amp/bom/system-candidate-capacitor-derating.csv

Reference | MPN | Nets | WorkingVoltage_V | RatedVoltage_V | Nominal_uF | Tolerance_pct | Dielectric | EstimatedBudget_uF | Requirement | Source | Disposition | VoltageUtilization_pct
C1 | 860020575014 | /AUX_RAW | /GND | 13.2 | 35 | 470 | 20 | Al electrolytic | 300.8 | 120Hz ripple<=.416Arms per part; do not apply low-Z MLCC ESR model | WE WCAP-ATG5 860020575014 rev1 p1:520mA120Hz105C; tolerance20%,EOLloss20% | SELECTION_ACCEPTED; bench qualification pending | 37.71
C3 | EMK212BJ106KG-T | /AUX_RAW | /GND | 13.2 | 16 | 10 | 10 | X5R | not used as guaranteed minimum | bypass in parallel C1; AUX supply sufficiency based C1 and C315/C316; no claim10uF effective | Taiyo EMK212BJ106KG-T rating16V10uF;82.5% voltage utilization; verify temp/ripple | SELECTION_ACCEPTED; bench qualification pending | 82.5
C4 | C0603C104K5RACTU | /GND | /GVDD_AB | 13.2 | 50 | 0.1 | 10 | X7R | nominal EVM decoupler | GVDD bypass; match TI EVM nominal; impedance/ripple bench | KEMET C0603C104K5RACTU; TPA3255 internal GVDD near12V | SELECTION_ACCEPTED; bench qualification pending | 26.4
C5 | C0603C104K5RACTU | /GND | /GVDD_CD | 13.2 | 50 | 0.1 | 10 | X7R | nominal EVM decoupler | GVDD bypass; match TI EVM nominal; impedance/ripple bench | KEMET C0603C104K5RACTU; TPA3255 internal GVDD near12V | SELECTION_ACCEPTED; bench qualification pending | 26.4
C6 | GRM188R71C105KA12D | /DVDD_INTERNAL | /GND | 8.5 | 16 | 1 | 10 | X7R | 0.2584 | internal DVDD/AVDD/VBG only; nominal TI EVM1uF retained; not external supply | Murata SimSurfing 0.469091uF at8.56V25C1Vrms; conservative8.5V envelope incl AVDD7.75V typical, not7V; TI TPA3255 nominal decouplers | SELECTION_ACCEPTED; bench qualification pending | 53.12
C7 | GRM188R71C105KA12D | /AVDD | /GND | 8.5 | 16 | 1 | 10 | X7R | 0.2584 | internal DVDD/AVDD/VBG only; nominal TI EVM1uF retained; not external supply | Murata SimSurfing 0.469091uF at8.56V25C1Vrms; conservative8.5V envelope incl AVDD7.75V typical, not7V; TI TPA3255 nominal decouplers | SELECTION_ACCEPTED; bench qualification pending | 53.12
C8 | GRM155R71E473KA88D | /C_START | /GND | 3.5 | 25 | 0.047 | 10 | X7R | 0.02589 | C_START timing: verify startup at temperature; no nominal47nF timing guarantee | Murata GRM155R71E473KA88D; SimSurfing near47.78nF at3.25V25C1Vrms; TI TPA3255 | SELECTION_ACCEPTED; bench qualification pending | 14.0
C9 | GRM188R71C105KA12D | /GND | /VBG | 8.5 | 16 | 1 | 10 | X7R | 0.2584 | internal DVDD/AVDD/VBG only; nominal TI EVM1uF retained; not external supply | Murata SimSurfing 0.469091uF at8.56V25C1Vrms; conservative8.5V envelope incl AVDD7.75V typical, not7V; TI TPA3255 nominal decouplers | SELECTION_ACCEPTED; bench qualification pending | 53.12
C10 | GRM31CR72A105KA01L | /GND | /PVDD | 53.5 | 100 | 1 | 10 | X7R | 0.2538 | 4 parts total budget>=1uF; each local decoupler as TI EVM; switching ripple/temperature test | Murata SimSurfing .46076uF at53.5V25C10mVrms; extra temp15%,tol10%,age20%,model10%; TPA3255EVM BOM | SELECTION_ACCEPTED; bench qualification pending | 53.5
C11 | GRM31CR72A105KA01L | /GND | /PVDD | 53.5 | 100 | 1 | 10 | X7R | 0.2538 | 4 parts total budget>=1uF; each local decoupler as TI EVM; switching ripple/temperature test | Murata SimSurfing .46076uF at53.5V25C10mVrms; extra temp15%,tol10%,age20%,model10%; TPA3255EVM BOM | SELECTION_ACCEPTED; bench qualification pending | 53.5
C12 | GRM31CR72A105KA01L | /GND | /PVDD | 53.5 | 100 | 1 | 10 | X7R | 0.2538 | 4 parts total budget>=1uF; each local decoupler as TI EVM; switching ripple/temperature test | Murata SimSurfing .46076uF at53.5V25C10mVrms; extra temp15%,tol10%,age20%,model10%; TPA3255EVM BOM | SELECTION_ACCEPTED; bench qualification pending | 53.5
C13 | GRM31CR72A105KA01L | /GND | /PVDD | 53.5 | 100 | 1 | 10 | X7R | 0.2538 | 4 parts total budget>=1uF; each local decoupler as TI EVM; switching ripple/temperature test | Murata SimSurfing .46076uF at53.5V25C10mVrms; extra temp15%,tol10%,age20%,model10%; TPA3255EVM BOM | SELECTION_ACCEPTED; bench qualification pending | 53.5
C14 | UHE1J681MHD | /GND | /PVDD | 53.5 | 63 | 680 | 20 | Al electrolytic | 435.2 | each ripple weighted<=.8 of rated;120Hz limit=.768Arms; current sharing/temperature test | Nichicon UHE CAT8100M pp1/6:1280mA100kHz105C;390-1000uF coefficient120Hz=.75; capacitance tolerance20%,EOLloss20% | SELECTION_ACCEPTED; bench qualification pending | 84.92
C15 | UHE1J681MHD | /GND | /PVDD | 53.5 | 63 | 680 | 20 | Al electrolytic | 435.2 | each ripple weighted<=.8 of rated;120Hz limit=.768Arms; current sharing/temperature test | Nichicon UHE CAT8100M pp1/6:1280mA100kHz105C;390-1000uF coefficient120Hz=.75; capacitance tolerance20%,EOLloss20% | SELECTION_ACCEPTED; bench qualification pending | 84.92
C16 | GRM188R71E333KA01D | /BST_A | /PWM_AC | 13.2 | 25 | 0.033 | 10 | X7R | 0.01707 | bootstrap: differential BST-OUT only; match TI EVM33nF; verify gate-drive ripple | Murata SimSurfing31.45nF at12V25C1Vrms; working13.2V selection envelope; DC common-mode53.5V is not differential voltage | SELECTION_ACCEPTED; bench qualification pending | 52.8
C17 | GRM188R71E333KA01D | /BST_B | /PWM_BD | 13.2 | 25 | 0.033 | 10 | X7R | 0.01707 | bootstrap: differential BST-OUT only; match TI EVM33nF; verify gate-drive ripple | Murata SimSurfing31.45nF at12V25C1Vrms; working13.2V selection envelope; DC common-mode53.5V is not differential voltage | SELECTION_ACCEPTED; bench qualification pending | 52.8
C18 | GRM188R71E333KA01D | /BST_C | /PWM_AC | 13.2 | 25 | 0.033 | 10 | X7R | 0.01707 | bootstrap: differential BST-OUT only; match TI EVM33nF; verify gate-drive ripple | Murata SimSurfing31.45nF at12V25C1Vrms; working13.2V selection envelope; DC common-mode53.5V is not differential voltage | SELECTION_ACCEPTED; bench qualification pending | 52.8
C19 | GRM188R71E333KA01D | /BST_D | /PWM_BD | 13.2 | 25 | 0.033 | 10 | X7R | 0.01707 | bootstrap: differential BST-OUT only; match TI EVM33nF; verify gate-drive ripple | Murata SimSurfing31.45nF at12V25C1Vrms; working13.2V selection envelope; DC common-mode53.5V is not differential voltage | SELECTION_ACCEPTED; bench qualification pending | 52.8
C22 | MKP2D034701M00JSSD | /GND | /SPK_P | 53.5 | 100 | 0.47 | 5 | Polypropylene | 0.4465 | output LC: capacitor current/temperature/AC stress; no MLCC bias loss | WIMA MKP2D034701M00JSSD;100VDC5% PP; filtered SPK toGND still has common-mode | SELECTION_ACCEPTED; bench qualification pending | 53.5
C23 | MKP2D034701M00JSSD | /GND | /SPK_P | 53.5 | 100 | 0.47 | 5 | Polypropylene | 0.4465 | output LC: capacitor current/temperature/AC stress; no MLCC bias loss | WIMA MKP2D034701M00JSSD;100VDC5% PP; filtered SPK toGND still has common-mode | SELECTION_ACCEPTED; bench qualification pending | 53.5
C24 | 12061A102JAT2A | /GND | /SPK_P | 53.5 | 100 | 0.001 | 5 | C0G | 0.00095 | output HF capacitor current/temperature; full output-node voltage envelope | KYOCERA12061A102JAT2A100V5%C0G | SELECTION_ACCEPTED; bench qualification pending | 53.5
C25 | 06031C103KAT2A | /SPK_P | /SPK_P_SNUB | 53.5 | 100 | 0.01 | 10 | X7R | snubber; not reservoir | SPK-SNUB: AC/pulse current and dielectric heat checked under PWM | KYOCERA06031C103KAT2A100V;53.5V conservative differential edge envelope | SELECTION_ACCEPTED; bench qualification pending | 53.5
C26 | MKP2D034701M00JSSD | /GND | /SPK_N | 53.5 | 100 | 0.47 | 5 | Polypropylene | 0.4465 | output LC: capacitor current/temperature/AC stress; no MLCC bias loss | WIMA MKP2D034701M00JSSD;100VDC5% PP; filtered SPK toGND still has common-mode | SELECTION_ACCEPTED; bench qualification pending | 53.5
C27 | MKP2D034701M00JSSD | /GND | /SPK_N | 53.5 | 100 | 0.47 | 5 | Polypropylene | 0.4465 | output LC: capacitor current/temperature/AC stress; no MLCC bias loss | WIMA MKP2D034701M00JSSD;100VDC5% PP; filtered SPK toGND still has common-mode | SELECTION_ACCEPTED; bench qualification pending | 53.5
C28 | 12061A102JAT2A | /GND | /SPK_N | 53.5 | 100 | 0.001 | 5 | C0G | 0.00095 | output HF capacitor current/temperature; full output-node voltage envelope | KYOCERA12061A102JAT2A100V5%C0G | SELECTION_ACCEPTED; bench qualification pending | 53.5
C29 | 06031C103KAT2A | /SPK_N | /SPK_N_SNUB | 53.5 | 100 | 0.01 | 10 | X7R | snubber; not reservoir | SPK-SNUB: AC/pulse current and dielectric heat checked under PWM | KYOCERA06031C103KAT2A100V;53.5V conservative differential edge envelope | SELECTION_ACCEPTED; bench qualification pending | 53.5
C201 | 860020575014 | /ANALOG_12V | /GND | 13.2 | 35 | 470 | 20 | Al electrolytic | 300.8 | 120Hz ripple<=.416Arms per part; do not apply low-Z MLCC ESR model | WE WCAP-ATG5 860020575014 rev1 p1:520mA120Hz105C; tolerance20%,EOLloss20% | SELECTION_ACCEPTED; bench qualification pending | 37.71
C202 | 860020575014 | /ANALOG_12V | /GND | 13.2 | 35 | 470 | 20 | Al electrolytic | 300.8 | 120Hz ripple<=.416Arms per part; do not apply low-Z MLCC ESR model | WE WCAP-ATG5 860020575014 rev1 p1:520mA120Hz105C; tolerance20%,EOLloss20% | SELECTION_ACCEPTED; bench qualification pending | 37.71
C301 | 63USC4700MEFCSN30X30 | /GND | /PVDD | 53.5 | 63 | 4700 | 20 | Al electrolytic | 3008 | each ripple weighted<=.8 of rated;120Hz limit2.792Arms; case<70C; no lifetime guarantee | Rubycon USC datasheet:85C3000h;63V4700uF30x30 ripple3.49A120Hz; tolerance20%,EOLloss20% | SELECTION_ACCEPTED; bench qualification pending | 84.92
C302 | 63USC4700MEFCSN30X30 | /GND | /PVDD | 53.5 | 63 | 4700 | 20 | Al electrolytic | 3008 | each ripple weighted<=.8 of rated;120Hz limit2.792Arms; case<70C; no lifetime guarantee | Rubycon USC datasheet:85C3000h;63V4700uF30x30 ripple3.49A120Hz; tolerance20%,EOLloss20% | SELECTION_ACCEPTED; bench qualification pending | 84.92
C310 | CGA6N3X7R2A225K230AB | /GND | /PVDD | 53.5 | 100 | 2.2 | 10 | X7R | 0.4605 | pair>=.9uF effective; buck input ripple<=.6Vpp at0.5A; switching loop review/bench | TDK characterization2016-01-04 p1 ~60% bias loss at53.5V; retention.38 conservative graph reading, temp15%,tol10%,age20%,model10%; TI SNVSAU4D7.2.2.5 | SELECTION_ACCEPTED; bench qualification pending | 53.5
C311 | CGA6N3X7R2A225K230AB | /GND | /PVDD | 53.5 | 100 | 2.2 | 10 | X7R | 0.4605 | pair>=.9uF effective; buck input ripple<=.6Vpp at0.5A; switching loop review/bench | TDK characterization2016-01-04 p1 ~60% bias loss at53.5V; retention.38 conservative graph reading, temp15%,tol10%,age20%,model10%; TI SNVSAU4D7.2.2.5 | SELECTION_ACCEPTED; bench qualification pending | 53.5
C312 | GCM155R71H222KA37D | /BUCK_BST | /BUCK_SW | 5.5 | 50 | 0.0022 | 10 | X7R | 0.001212 | buck bootstrap: differential BST-SW; TI nominal2.2nF retained | Murata SimSurfing2.2338nF at5V25C1Vrms; TI LM5164 internal bootstrapVCC | SELECTION_ACCEPTED; bench qualification pending | 11.0
C313 | CGA3E2X7R2A332K080AA | /AUX_RAW | /BUCK_RAMP | 13.2 | 100 | 0.0033 | 10 | X7R | timing network; nominal TI | ramp/feedback compensation; stability checked in BENCH-002 | TDK CGA3E2X7R2A332K080AA; VIN differential peak bounded by AUX envelope for RAMP-AUX; TI LM5164 type3 injection | SELECTION_ACCEPTED; bench qualification pending | 13.2
C314 | C0603C560J5GACTU | /BUCK_FB | /BUCK_RAMP | 13.2 | 50 | 5.6e-05 | 5 | C0G | 5.32e-05 | feedback injection stable dielectric; not power reservoir | KEMET C0603C560J5GACTU 56pF5%50V; TI LM5164 type3 injection | SELECTION_ACCEPTED; bench qualification pending | 26.4
C315 | TMK325B7226KMHT | /AUX_RAW | /GND | 13.2 | 25 | 22 | 10 | X7R | 3.3929 | pair>=6uF effective (TI example requires>3uF); AUX ripple<=120mVpp | Taiyo Yuden TMK325B7226KM-PR_SS p2: retention>=.28 at13.2V conservative graph reading; tol10%,temp15%,age20%,model10%; HT packaging same electrical root; procurement lifecycle review retained | SELECTION_ACCEPTED; bench qualification pending | 52.8
C316 | TMK325B7226KMHT | /AUX_RAW | /GND | 13.2 | 25 | 22 | 10 | X7R | 3.3929 | pair>=6uF effective (TI example requires>3uF); AUX ripple<=120mVpp | Taiyo Yuden TMK325B7226KM-PR_SS p2: retention>=.28 at13.2V conservative graph reading; tol10%,temp15%,age20%,model10%; HT packaging same electrical root; procurement lifecycle review retained | SELECTION_ACCEPTED; bench qualification pending | 52.8
C320 | C0603C104K5RACTU | /AUX_RAW | /GND | 13.2 | 50 | 0.1 | 10 | X7R | local bypass | local AUX monitor bypass; match nominal TI | KEMET C0603C104K5RACTU50V | SELECTION_ACCEPTED; bench qualification pending | 26.4
C401 | GRM21BR61H106KE43L | /AUX_RAW | /GND | 13.2 | 50 | 10 | 10 | X5R | 1.3518 | effective >=1uF; case<70C; within10mm U401 | Murata SimSurfing tc=-20/25/70C ac=.01Vrms dc13.25V; tolerance10%,age reserve20%,model reserve10%; TI SLVS522S7.1.2.1 | SELECTION_ACCEPTED; bench qualification pending | 26.4
C402 | 06031C103KAT2A | /GND | /SEQ_BYP | 1.3 | 100 | 0.01 | 10 | X7R | noise bypass; nominal TI | LP2985 BYPASS 10nF nominal; startup/noise measured in bench | KYOCERA06031C103KAT2A100V; TI LP2985 internal reference | SELECTION_ACCEPTED; bench qualification pending | 1.3
C403 | GRM188R61E106MA73D | /GND | /SEQ_3V3 | 3.5 | 25 | 10 | 20 | X5R | 2.4867 | effective >=2.2uF; legacy ESR>=5mOhm including copper; new ESR<=1Ohm; case<70C | Murata SimSurfing tc=-20/25/70C ac=.01Vrms dc3.5V; tolerance20%,age20%,model10%; TI SLVS522S7.1.2.2 | SELECTION_ACCEPTED; bench qualification pending | 14.0
C416 | C0603C104K5RACTU | /AUX_RAW | /GND | 13.2 | 50 | 0.1 | 10 | X7R | local bypass | local AUX monitor bypass; match nominal TI | KEMET C0603C104K5RACTU50V | SELECTION_ACCEPTED; bench qualification pending | 26.4
C417 | C0603C104K5RACTU | /AUX_RAW | /GND | 13.2 | 50 | 0.1 | 10 | X7R | local bypass | local AUX monitor bypass; match nominal TI | KEMET C0603C104K5RACTU50V | SELECTION_ACCEPTED; bench qualification pending | 26.4
C601 | C3216X7R1E106K160AB | /GND | /P15V | 16 | 25 | 10 | 10 | X7R | local bypass; no guaranteed10uF | P15V/N15V decoupling; retained regulator network; transients/temp bench | TDK C3216X7R1E106K160AB; polarity not applicable;64% voltage utilization | SELECTION_ACCEPTED; bench qualification pending | 64.0
C602 | C0603C104K5RACTU | /GND | /P15_BASE | 17 | 50 | 0.1 | 10 | X7R | local bypass | positive/negative15V zener base nominal16V; envelope17V incl tolerance | KEMET C0603C104K5RACTU50V | SELECTION_ACCEPTED; bench qualification pending | 34.0
C603 | UHE1J121MPD | /GND | /NRAW | 53.5 | 63 | 120 | 20 | Al electrolytic | 76.8 | negative rail capacitor: positive terminal GND;120Hz ripple<=.2285Arms | Nichicon UHE CAT8100M:408mA100kHz;39-330uF coefficient120Hz=.70; tolerance20%,EOLloss20% | SELECTION_ACCEPTED; bench qualification pending | 84.92
C604 | C3216X7R1E106K160AB | /GND | /N15V | 16 | 25 | 10 | 10 | X7R | local bypass; no guaranteed10uF | P15V/N15V decoupling; retained regulator network; transients/temp bench | TDK C3216X7R1E106K160AB; polarity not applicable;64% voltage utilization | SELECTION_ACCEPTED; bench qualification pending | 64.0
C605 | C0603C104K5RACTU | /GND | /N15_BASE | 17 | 50 | 0.1 | 10 | X7R | local bypass | positive/negative15V zener base nominal16V; envelope17V incl tolerance | KEMET C0603C104K5RACTU50V | SELECTION_ACCEPTED; bench qualification pending | 34.0
