bernardopg/ps28-modern-amp/kicad/models/vendor-wurth/L_Wurth_WE-HCF-2013.step

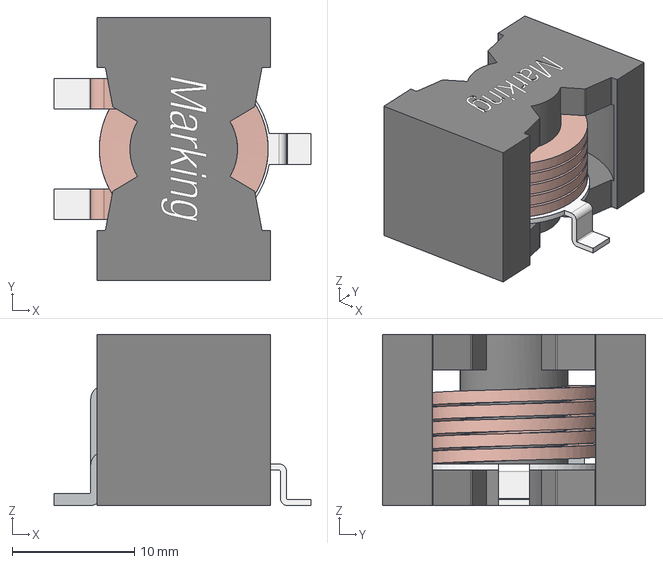
[picture p24: CAD file, 2026-10-08]
kicad/models/vendor-wurth/L_Wurth_WE-HCF-2013.step
21.0 x 21.5 x 14.0 mm
