bernardopg/ps28-modern-amp/mechanical/thermal-block.stl

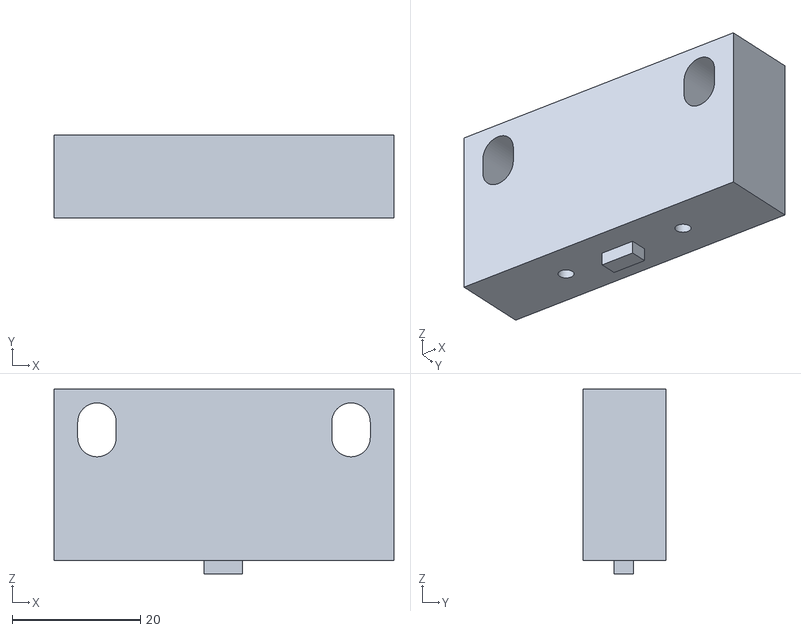
[picture p25: CAD file, 2026-10-16]
mechanical/thermal-block.stl
53.0 x 13.0 x 28.8
