bernardopg/ps28-modern-amp/kicad/models/vendor-wurth/CP_Wurth_WCAP-ATG5-P5D10L16.step

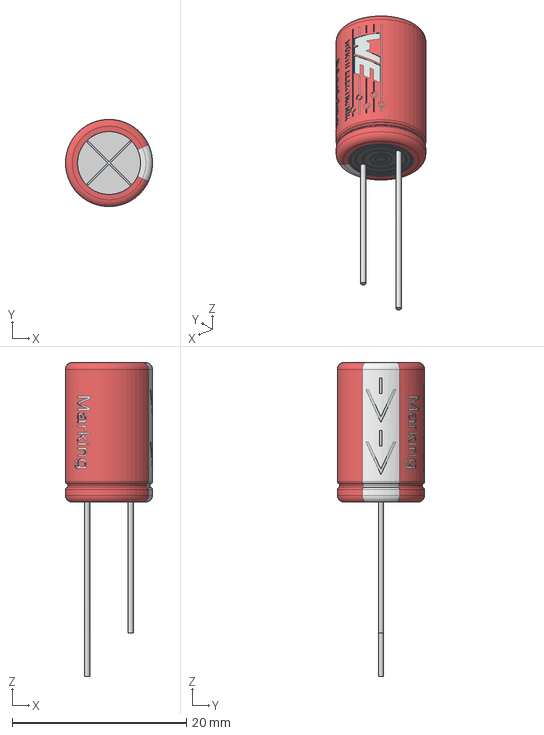
[picture p26: CAD file, 2026-10-08]
kicad/models/vendor-wurth/CP_Wurth_WCAP-ATG5-P5D10L16.step
9.99 x 10.00 x 36.0 mm
