bernardopg/ps28-modern-amp/manufacturing/README.md

# Manufacturing

Nenhum arquivo está liberado para produção. docs/manufacturing.md define G3.
Exports de trabalho em build/; pacote aprovado em releases/<rev>-<commit>/ com hash.
