bernardopg/ps28-modern-amp/.tasks/items/SETUP-001.md

---
id: SETUP-001
title: Estrutura, documentação e skills
status: Done
milestone: M0
sprint: S01
depends_on: none
updated: 2026-10-07
---

# SETUP-001 — Estrutura, documentação e skills

## Objetivo

Estrutura, documentação e skills, atendendo docs/requirements.md e gates docs/safety.md.

## Critérios de aceite

- [x] Originais preservados e documentação/gates estruturados
- [x] Skills têm frontmatter, links locais e prompts de avaliação

## Evidência

Ver README.md, docs/source-review.md e skills/README.md.

## Risco / aprovação

Alterações de hardware exigem fonte primária e gate humano; sem pedidos automáticos.
