bernardopg/ps28-modern-amp/mechanical/measurement-request.md

# Medidas solicitadas ao proprietário

Nenhuma pendente (2026-10-12). Respostas da última rodada registradas em
`oem-heatsink-measurements.md` (6ª rodada) e `oem-harness-sealing.md`.
Próxima medida prevista: primeira energização controlada (BENCH-002).
