bernardopg/ps28-modern-amp/docs/images/analog-protected/analog-protected.pdf

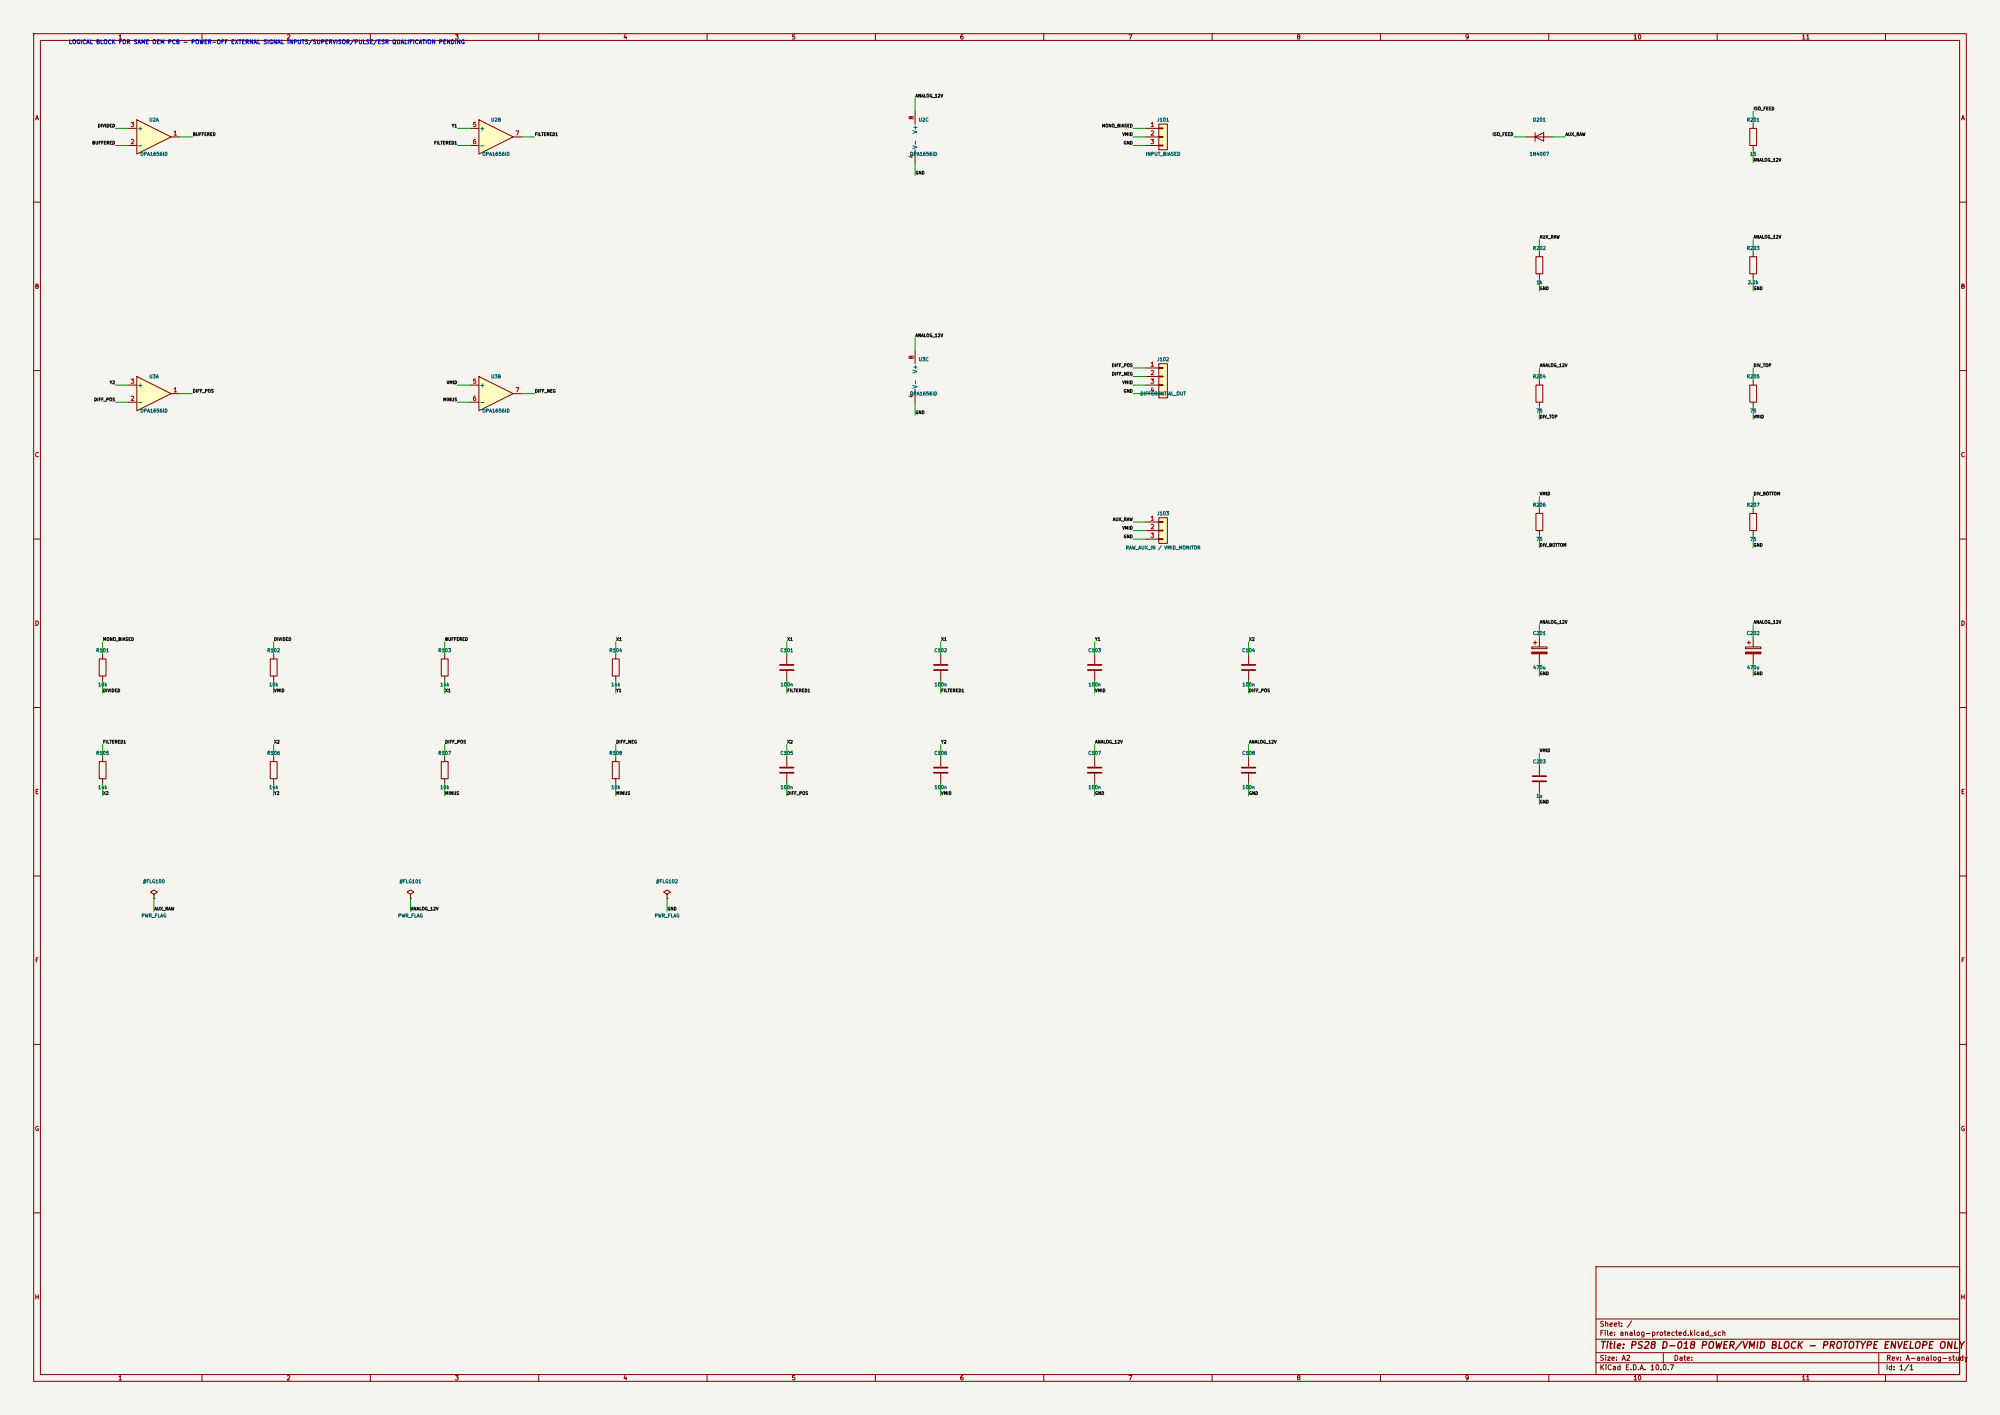
[picture p27: page 1]

ANALOG_12V LOGICAL BLOCK FOR SAME OEM PCB - POWER-OFF EXTERNAL SIGNAL INPUTS/SUPERVISOR/PULSE/ESR QUALIFICATION PENDING

Sheet: /
File: analog-protected.kicad_sch
Title: PS28 D-018 POWER/VMID BLOCK - PROTOTYPE ENVELOPE ONLY
KiCad E.D.A. 10.0.7
