bernardopg/ps28-modern-amp/docs/images/analog-front-end/analog-front-end.pdf

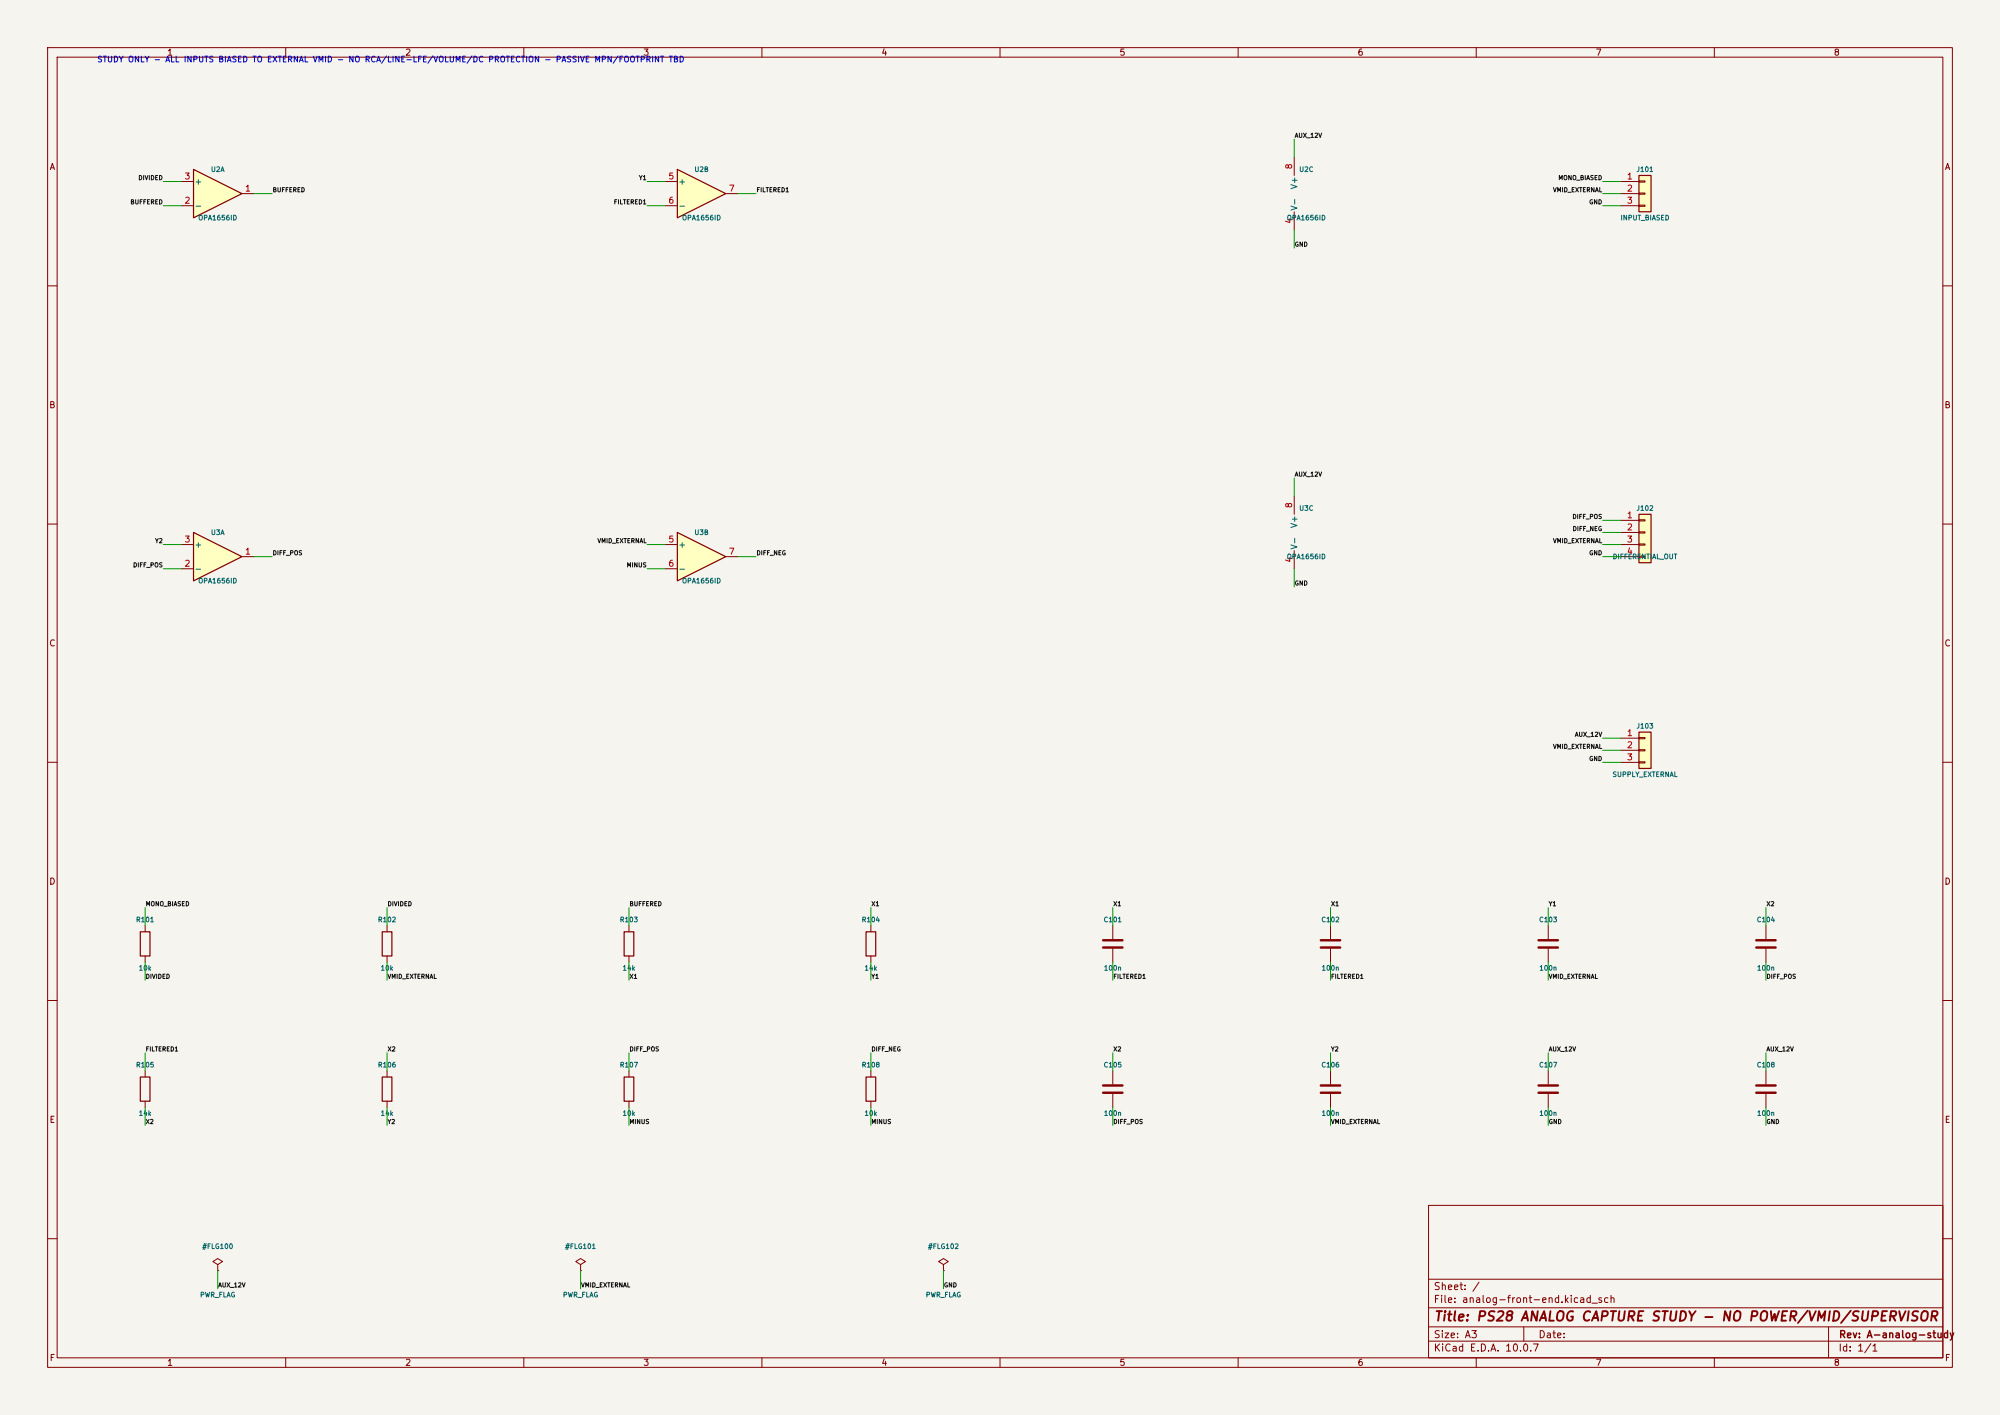
[picture p28: page 1]

GND STUDY ONLY - ALL INPUTS BIASED TO EXTERNAL VMID - NO RCA/LINE-LFE/VOLUME/DC PROTECTION - PASSIVE MPN/FOOTPRINT TBD

Sheet: /
File: analog-front-end.kicad_sch
Title: PS28 ANALOG CAPTURE STUDY - NO POWER/VMID/SUPERVISOR

F Date:

KiCad E.D.A. 10.0.7 | Id: 1/1
