bernardopg/ps28-modern-amp/(list of files, drawings)

Other design files:
tests/reports/pcb-readiness-review.json
