bernardopg/ps28-modern-amp/kicad/system-candidate/system-candidate.kicad_pcb

## KiCad design kicad/system-candidate/system-candidate.kicad_pcb (2026-10-17)

Schematic: system-candidate.kicad_sch, PS28 CORE + ANALOG + D-021 POWER + D-020 SEQ SUBSET - INCOM…

Parts:
C1: 470uF 35V; WE_860020575014; MPN 860020575014
C2, C4, C5: 100nF 50V X7R; C_0603_1608Metric; MPN C0603C104K5RACTU
C3, C20, C21: 10uF 16V X5R; C_0805_2012Metric; MPN EMK212BJ106KG-T
C6, C7, C9: 1uF 16V X7R; C_0603_1608Metric; MPN GRM188R71C105KA12D
C8: 47nF 25V X7R; C_0402_1005Metric; MPN GRM155R71E473KA88D
C10, C11, C12, C13: 1uF 100V X7R; C_1206_3216Metric; MPN GRM31CR72A105KA01L
C14, C15: 680uF 63V; CP_Radial_D12.5mm_P5.00mm; MPN UHE1J681MHD
C16, C17, C18, C19: 33nF 25V X7R; C_0603_1608Metric; MPN GRM188R71E333KA01D
C22, C23, C26, C27: 470nF 100V PP 5%; C_Rect_L7.2mm_W8.5mm_P5.00mm_FKP2_FKP2_MKS2_MKP2; MPN MKP2D034701M00JSSD
C24, C28: 1nF 100V C0G; C_1206_3216Metric; MPN 12061A102JAT2A
C25, C29: 10nF 100V X7R; C_0603_1608Metric; MPN 06031C103KAT2A
C107, C108: 100n; C_0805_2012Metric; MPN C0805C104K5RACTU
C109: 2.2u 63V film; C_Rect_L7.2mm_W7.2mm_P5.00mm_FKS2_FKP2_MKS2_MKP2; MPN MKS2C042201K00JSSD
C201, C202: 470u; WE_860020575014; MPN 860020575014
C203: 1u; C_Rect_L7.2mm_W11.0mm_P5.00mm_FKS2_FKP2_MKS2_MKP2; MPN MKP2C041001N00JSSD
C301, C302: 4700u 63V snap-in; CP_Radial_D30.0mm_P10.00mm_SnapIn; MPN 63USC4700MEFCSN30X30
C310, C311: 2.2u 100V X7R; C_1210_3225Metric; MPN CGA6N3X7R2A225K230AB
C312: 2.2n 50V X7R; C_0402_1005Metric; MPN GCM155R71H222KA37D
C313: 3.3n; C_0603_1608Metric; MPN CGA3E2X7R2A332K080AA
C314: 56p; C_0603_1608Metric; MPN C0603C560J5GACTU
C315, C316: 22u 25V X7R; C_1210_3225Metric; MPN TMK325B7226KMHT
C320, C406, C407, C408, C409, C410, C411, C412, C413, C414, C415, C416, C417, C418, C419, C420, C421, C422, C423, C505, C506, C507, C508, C602, C605: 100n; C_0603_1608Metric; MPN C0603C104K5RACTU
C401: 10u 50V; C_0805_2012Metric; MPN GRM21BR61H106KE43L
C402: 10n; C_0603_1608Metric; MPN 06031C103KAT2A
C403: 10u 25V; C_0603_1608Metric; MPN GRM188R61E106MA73D
C404: 180n; C_0603_1608Metric; MPN GRM188R71E184KA88D
C405: 1u; C_0603_1608Metric; MPN GRM188R71E105KA12D
C503, C504: 4.7n C0G; C_0603_1608Metric; MPN C0603C472J5GACTU
C509, C511: 330n; C_0603_1608Metric; MPN C0603C334K4RACTU
C510, C512: 680n; C_0603_1608Metric; MPN CC0603KRX7R8BB684
C601, C604: 10u 25V; C_1206_3216Metric; MPN C3216X7R1E106K160AB
C603: 120u 63V; CP_Radial_D8.0mm_P3.50mm; MPN UHE1J121MPD
D201: 1N4007; D_DO-41_SOD81_P10.16mm_Horizontal; MPN 1N4007-E3/54
D301, D302: P600J; D_P600_R-6_P12.70mm_Horizontal; MPN P600J-E3/54
D303: SMCJ51A; D_SMC; MPN SMCJ51A
D501: 1N4148W; D_SOD-123; MPN 1N4148W-7-F
D502: BZT52C15; D_SOD-123; MPN BZT52C15-7-F
D503, D504: BAT54; SOT-23; MPN BAT54-7-F
D601, D604: BZT52C16; D_SOD-123; MPN BZT52C16-7-F
D602, D603, D707: S1M; D_SMA; MPN S1M-E3/61T
D701: PVDD; LED_0805_2012Metric; MPN LTST-C171GKT
D702: RAILS_OK; LED_0805_2012Metric; MPN LTST-C171GKT
D703: RUN; LED_0805_2012Metric; MPN LTST-C171GKT
D704: AUDIO; LED_0805_2012Metric; MPN LTST-C171GKT
D705: FAULT; LED_0805_2012Metric; MPN LTST-C171GKT
D706: CLIP_OTW; LED_0805_2012Metric; MPN LTST-C171GKT
F301: T6.3A slow; Fuseholder_Cylinder-5x20mm_Schurter_0031_8201_Horizontal_Op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; MPN 0031.8201
J1: 691137710002 2P 5.00mm; WE_WR_TBL_691137710002; MPN 691137710002
J2: Auxiliary 12V; PinHeader_1x02_P2.54mm_Vertical; MPN PBC02SAAN
J3: Differential audio; PinHeader_1x03_P2.54mm_Vertical; MPN PBC03SAAN; not fitted
J4: Control 2x4: 3V3 RESET FAULT CLIP GND GND NC NC; PinHeader_2x04_P2.54mm_Vertical; MPN PEC04DAAN; not fitted
J5: B2P-VH(LF)(SN); JST_VH_B2P-VH_1x02_P3.96mm_Vertical; MPN B2P-VH(LF)(SN)
J6: GND braid solder bond - NO mounting hole; Ground_Bond_SMD_6mm; MPN PCB solder land + grounded braid assemb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
J7: B7B-XH-A(LF)(SN); JST_XH_B7B-XH-A_1x07_P2.50mm_Vertical; MPN B7B-XH-A(LF)(SN)
J8: FAN 12V; JST_XH_B2B-XH-A_1x02_P2.50mm_Vertical; MPN B2B-XH-A(LF)(SN)
J301: T1_SECONDARY; JST_VH_B3P-VH_1x03_P3.96mm_Vertical; MPN B3P-VH(LF)(SN)
J401: START_BUTTON; PinHeader_1x02_P2.54mm_Vertical; MPN PBC02SAAN
JP701: FAN MODE; PinHeader_1x03_P2.54mm_Vertical; MPN PBC03SAAN
K501: G6K-2F DC12; Relay_DPDT_Omron_G6K-2F; MPN G6K-2F DC12
L1, L2: 10uH 16A 22A_Isat_typ; WE_HCF2013_7443631000; MPN 7443631000
L301: 68u; L_Coilcraft_MSS1246T-XXX; MPN MSS1246T-683MLC
Q501, Q502: MMBT3904; SOT-23; MPN MMBT3904-7-F
Q601: BCP56; SOT-223-3_TabPin2; MPN BCP56T1G
Q602: BCP53; SOT-223-3_TabPin2; MPN BCP53T1G
Q603, Q701, Q702, Q703, Q704, Q705, Q706: BSS138; SOT-23; MPN BSS138LT1G
Q707: AO3400A; SOT-23; MPN AO3400A
R1, R2, R5, R6: 3.3R 0.25W 1%; R_1206_3216Metric; MPN CRCW12063R30FKEA
R3: 22k 1%; R_0603_1608Metric; MPN CRCW060322K0FKEA
R4: 30k 1%; R_0603_1608Metric; MPN CRCW060330K0FKEA
R7, R8: 10k 1%; R_0603_1608Metric; MPN CRCW060310K0FKEA; not fitted
R9: 4.7k 1%; R_0603_1608Metric; MPN CRCW06034K70FKEA
R101: 1k; R_0805_2012Metric; MPN CRCW08051K00FKEA
R102, R720: 100k; R_0805_2012Metric; MPN CRCW0805100KFKEA
R107, R108, R715, R716: 10k; R_0805_2012Metric; MPN CRCW080510K0FKEA
R110: 8.87k; R_0603_1608Metric; MPN RT0603BRD078K87L
R111: 10k; R_0603_1608Metric; MPN RT0603BRD0710KL
R201: 15; R_Axial_DIN0617_L17.0mm_D6.0mm_P5.08mm_Vertical; MPN AC03000001509JAC00
R202: 1k; TNPW1206_IPC_Reflow; MPN TNPW12061K00BEEA
R203: 2.2k; TNPW1206_IPC_Reflow; MPN TNPW12062K20BEEA
R204, R205, R206, R207: 75; R_1206_3216Metric; MPN CRCW120675R0FKEA
R301: 4.7k 2W; R_Axial_DIN0414_L11.9mm_D4.5mm_P15.24mm_Horizontal; MPN PR02000204701JA100
R310: 100k 1%; R_0603_1608Metric; MPN RT0603BRD07100KL
R311, R313: 453k 1%; R_0603_1608Metric; MPN RT0603BRD07453KL
R312: 49.9k 1%; R_0603_1608Metric; MPN RG1608P-4992-B-T5
R320: 931k 0.1%; R_1206_3216Metric; MPN RT1206BRD07931KL
R321: 6.04k 0.1%; R_0603_1608Metric; MPN RT0603BRD076K04L
R322: 7.32k 0.1%; R_0603_1608Metric; MPN RT0603BRD077K32L
R323, R401, R402, R403, R404, R405, R406, R428, R429, R430, R502, R511, R513: 100k; R_0603_1608Metric; MPN CRCW0603100KFKEA
R407, R512, R605: 10k; R_0603_1608Metric; MPN CRCW060310K0FKEA
R408, R503, R504: 1k; R_0603_1608Metric; MPN CRCW06031K00FKEA
R420, R422, R426: 1M; R_0603_1608Metric; MPN RT0603BRD071ML
R421: 46.4k; R_0603_1608Metric; MPN RT0603BRD0746K4L
R423: 30.1k; R_0603_1608Metric; MPN RT0603BRD0730K1L
R424: 909k; R_0603_1608Metric; MPN RT0603BRD07909KL
R425: 101k; R_0603_1608Metric; MPN RT0603BRD07101KL
R427: 64.9k; R_0603_1608Metric; MPN RT0603BRD0764K9L
R501: 2.2k; R_0603_1608Metric; MPN CRCW06032K20FKEA
R505, R508: 787k; R_0603_1608Metric; MPN RT0603BRD07787KL
R506, R509: 115k; R_0603_1608Metric; MPN RT0603BRD07115KL
R507, R510: 78.7k; R_0603_1608Metric; MPN RT0603BRD0778K7L
R514: 357k; R_0603_1608Metric; MPN RT0603BRD07357KL
R515: 1.5k; R_0603_1608Metric; MPN RT0603BRD071K5L
R516: 11.5k; R_0603_1608Metric; MPN RT0603BRD0711K5L
R517, R518: 3.3k; R_0603_1608Metric; MPN RT0603BRD073K3L
R601, R603: 470 1W; R_2512_6332Metric; MPN CRCW2512470RFKEG
R602, R604: 10k; R_1206_3216Metric; MPN CRCW120610K0FKEA
R701: 47k; R_1206_3216Metric; MPN CRCW120647K0FKEA
R702, R703, R704, R705, R706: 2.2k; R_0805_2012Metric; MPN CRCW08052K20FKEA
TP102: STB; TestPoint_Pad_D2.0mm; MPN PCB test pad, no part; preamp auto-on n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
TP103: PTC; TestPoint_Pad_D2.0mm; MPN PCB test pad, no part; OEM protection L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
TP110, TP130: GND; TestPoint_Pad_D2.0mm; MPN PCB test pad, no part
TP111: PVDD; TestPoint_Pad_D2.0mm; MPN PCB test pad, no part
TP112: 12V; TestPoint_Pad_D2.0mm; MPN PCB test pad, no part
TP113: +15V; TestPoint_Pad_D2.0mm; MPN PCB test pad, no part
TP114: -15V; TestPoint_Pad_D2.0mm; MPN PCB test pad, no part
TP115: A12V; TestPoint_Pad_D2.0mm; MPN PCB test pad, no part
TP116: VMID; TestPoint_Pad_D2.0mm; MPN PCB test pad, no part
TP117: 3V3; TestPoint_Pad_D2.0mm; MPN PCB test pad, no part
TP118: GVDD; TestPoint_Pad_D2.0mm; MPN PCB test pad, no part
TP119: RST; TestPoint_Pad_D2.0mm; MPN PCB test pad, no part
TP120: FLT; TestPoint_Pad_D2.0mm; MPN PCB test pad, no part
TP121: OTW; TestPoint_Pad_D2.0mm; MPN PCB test pad, no part
TP122: ROK; TestPoint_Pad_D2.0mm; MPN PCB test pad, no part
TP123: DCOK; TestPoint_Pad_D2.0mm; MPN PCB test pad, no part
TP124: IN; TestPoint_Pad_D2.0mm; MPN PCB test pad, no part
TP125: D+; TestPoint_Pad_D2.0mm; MPN PCB test pad, no part
TP126: D-; TestPoint_Pad_D2.0mm; MPN PCB test pad, no part
TP127: INA; TestPoint_Pad_D2.0mm; MPN PCB test pad, no part
TP128: INB; TestPoint_Pad_D2.0mm; MPN PCB test pad, no part
TP129: CT; TestPoint_Pad_D2.0mm; MPN PCB test pad, no part
U1: TPA3255DDV; HTSSOP-44_6.1x14mm_P0.635mm_TopEP4.14x7.01mm; MPN TPA3255DDVR
U2, U3: OPA1656ID; SOIC-8_3.9x4.9mm_P1.27mm; MPN OPA1656ID
U302: LM5164DDA; HSOP-8-1EP_3.9x4.9mm_P1.27mm_EP2.41x3.1mm; MPN LM5164DDAR
U303, U412, U413, U501, U502, U504: TPS3700DDC; SOT-23-6; MPN TPS3700DDCR
U401: LP2985-33; SOT-23-5; MPN LP2985-33DBVR
U402, U403, U404, U414, U416: TPS3808G33; SOT-23-6; MPN TPS3808G33DBVR
U405: 74LVC1G14; SOT-23-5; MPN SN74LVC1G14DBVR
U406, U407, U417: 74LVC2G74; SSOP-8_2.95x2.8mm_P0.65mm; MPN SN74LVC2G74DCTR
U408, U418: 74LVC1G32; SOT-23-5; MPN SN74LVC1G32DBVR
U409, U419: 74LVC1G07; SOT-23-5; MPN SN74LVC1G07DBVR
U410, U415: 74LVC1G08; SOT-23-5; MPN SN74LVC1G08DBVR
U411: 74LVC1G06; SOT-23-5; MPN SN74LVC1G06DBVR
U503: TMUX6219; TI_DGK0008A; MPN TMUX6219DGKR

Connections:
/ANALOG_12V: C107.1, C108.1, C201.1, C202.1, C505.1, R201.2, R203.1, R204.1, R420.1, R422.1, R511.1, TP115.1, U2.8 (V+), U3.8 (V+), U503.4 (VDD)
/ANALOG_OV: R422.2, R423.1, U412.4 (INB-)
/ANALOG_UV: R420.2, R421.1, U412.3 (INA+)
/ARMED: U407.5 (Q), U415.1
/AUDIO_EN: R512.1, U417.5 (Q)
/AUX_OV: R515.2, R516.1, U504.4 (INB-)
/AUX_RAW: C1.1, C2.1, C3.1, C313.2, C315.1, C316.1, C320.1, C401.1, C416.1, C417.1, C506.1, C507.1, C508.1, D201.2 (A), D502.2 (A), D707.1 (K), J2.1, J8.1, K501.1, L301.2, R1.1, R2.1, R202.1, R311.1, R514.1, R702.1, R703.1, R704.1, R705.1, R706.1, TP112.1, U1.2 (VDD), U303.5 (VDD), U401.1 (VIN), U401.3 (ON/OFF), U412.5 (VDD), U413.5 (VDD), U501.5 (VDD), U502.5 (VDD), U504.5 (VDD)
/AUX_UV: R514.2, R515.1, U504.3 (INA+)
/AVDD: C7.1, U1.14 (AVDD)
/BST_A: C16.1, U1.44 (BST_A)
/BST_B: C17.1, U1.43 (BST_B)
/BST_C: C18.1, U1.24 (BST_C)
/BST_D: C19.1, U1.23 (BST_D)
/BUCK_BST: C312.1, U302.7 (BST)
/BUCK_FB: C314.2, R311.2, R312.1, U302.5 (FB)
/BUCK_RAMP: C313.1, C314.1, R313.2
/BUCK_RON: R310.1, U302.4 (RON)
/BUCK_SW: C312.2, L301.1, R313.1, U302.8 (SW)
/BUFFERED: R110.1, U2.1, U3.3 (+)
/CLIP_N: JP701.3, Q705.3 (D), Q706.1 (G), R716.2
/CLIP_OTW: J4.4, Q603.1 (G), Q705.1 (G), R8.2, TP121.1, U1.21 (~CLIP_OTW), U406.2 (D)
/C_START: C8.1, U1.15 (C_START)
/DC_GATE: U415.4, U416.3 (~MR)
/DC_OK: R429.2, TP123.1, U415.2, U418.2, U501.1 (OUTA), U501.6 (OUTB), U502.1 (OUTA), U502.6 (OUTB)
/DC_TRIP_N: U418.4, U419.2
/DIFF_N: C21.1, J3.2, R108.1, TP126.1, U3.7
/DIFF_P: C20.1, J3.1, R107.1, TP125.1, U3.1, U3.2 (-)
/DIVIDED: R101.2, R102.1, U2.3 (+), U503.1 (D)
/DIV_BOTTOM: R206.2, R207.1
/DIV_TOP: R204.2, R205.1
/DVDD_INTERNAL: C6.1, U1.4 (M2), U1.11 (DVDD)
/DWELL_OK: R430.2, U416.1 (~RESET), U417.1 (C)
/FAN_G: JP701.2, Q707.1 (G), R720.1
/FAN_N: D707.2 (A), J8.2, Q707.3 (D)
/FAULT: J4.3, Q703.1 (G), R7.2, TP120.1, U1.19 (~FAULT), U407.1 (C), U408.2
/FAULT_N: Q703.3 (D), Q704.1 (G), R715.2
/FAULT_TRIP_N: U408.4, U409.2
/FREQ_ADJ: R4.1, U1.8 (FREQ_ADJ)
/GND: C1.2, C2.2, C3.2, C4.2, C5.2, C6.2, C7.2, C8.2, C9.2, C10.2, C11.2, C12.2, C13.2, C14.2, C15.2, C22.2, C23.2, C24.2, C26.2, C27.2, C28.2, C107.2, C108.2, C201.2, C202.2, C203.2, C301.2, C302.2, C310.2, C311.2, C315.2, C316.2, C320.2, C401.2, C402.2, C403.2, C404.2, C405.2, C406.2, C407.2, C408.2, C409.2, C410.2, C411.2, C412.2, C413.2, C414.2, C415.2, C416.2, C417.2, C418.2, C419.2, C420.2, C421.2, C422.2, C423.2, C503.2, C504.2, C505.2, C506.2, C507.2, C508.2, C509.2, C510.2, C511.2, C512.2, C601.2, C602.2, C603.1, C604.1, C605.1, D303.2 (A2), D503.1 (A), D504.1 (A), D601.2 (A), D604.1 (K), D701.1 (K), F301.2, J1.2, J2.2, J3.3, J4.5, J4.6, J6.1, J7.4, J401.2, Q501.2 (E), Q502.2 (E), Q603.2 (S), Q701.2 (S), Q702.2 (S), Q703.2 (S), Q704.2 (S), Q705.2 (S), Q706.2 (S), Q707.2 (S), R3.2, R4.2, R5.2, R6.2, R9.2, R202.2, R203.2, R207.2, R301.2, R310.2, R312.2, R322.2, R421.2, R423.2, R425.2, R427.2, R502.2, R503.2, R504.2, R507.2, R510.2, R513.2, R516.2, R720.2, TP110.1, TP130.1, U1.3 (M1), U1.12 (GND), U1.13 (GND), U1.16 (INPUT_C), U1.17 (INPUT_D), U1.25 (GND), U1.26 (GND), U1.33 (GND), U1.34 (GND), U1.41 (GND), U1.42 (GND), U2.4 (V-), U3.4 (V-), U302.1 (GND), U302.9 (EP), U303.2 (GND), U401.2 (GND), U402.2 (GND), U403.2 (GND), U404.2 (GND), U405.3 (GND), U406.4 (GND), U407.4 (GND), U408.3 (GND), U409.3 (GND), U410.3 (GND), U411.3 (GND), U412.2 (GND), U413.2 (GND), U414.2 (GND), U415.3 (GND), U416.2 (GND), U417.4 (GND), U418.3 (GND), U419.3 (GND), U501.2 (GND), U502.2 (GND), U503.3 (GND), U503.6 (SEL), U503.7 (VSS), U503.8 (S2), U504.2 (GND); also elsewhere on the board
/GVDD_AB: C4.1, R1.2, TP118.1, U1.1 (GVDD_AB)
/GVDD_CD: C5.1, R2.2, U1.22 (GVDD_CD)
/INA_DIS: K501.2, R503.1
/INA_ISO: C20.2, K501.3
/INA_NO: K501.4, R517.1
/INA_OV: C510.1, R506.2, R507.1, U501.4 (INB-)
/INA_UV: C509.1, R505.2, R506.1, U501.3 (INA+)
/INB_DIS: K501.7, R504.1
/INB_ISO: C21.2, K501.6
/INB_NO: K501.5, R518.1
/INB_OV: C512.1, R509.2, R510.1, U502.4 (INB-)
/INB_UV: C511.1, R508.2, R509.1, U502.3 (INA+)
/INPUT_A_AC: C503.1, D503.3 (K), R505.1, R517.2, TP127.1, U1.5 (INPUT_A)
/INPUT_B_AC: C504.1, D504.3 (K), R508.1, R518.2, TP128.1, U1.6 (INPUT_B)
/ISO_FEED: D201.1 (K), R201.1
/LED701_A: D701.2 (A), R701.2
/LED702_A: D702.2 (A), R702.2
/LED703_A: D703.2 (A), R703.2
/LED704_A: D704.2 (A), R704.2
/LED705_A: D705.2 (A), R705.2
/LED705_K: D705.1 (K), Q704.3 (D)
/LED706_A: D706.2 (A), R706.2
/LED706_K: D706.1 (K), Q706.3 (D)
/LED_ROK_K: D702.1 (K), Q701.3 (D)
/LED_RUN_K: D703.1 (K), Q702.3 (D)
/LIMIT: J7.1, Q603.3 (D), R605.2
/MINUS: R107.2, R108.2, U3.6 (-)
/MONO_BIASED: C109.2, R101.1
/MUTE_BASE: Q502.1 (B), R512.2, R513.1
/MUTE_EN: Q502.3 (C), R511.2, U503.5 (EN)
/N15V: C604.2, J7.3, Q602.3 (E), TP114.1
/N15_BASE: C605.2, D604.2 (A), Q602.1 (B), R604.2
/N15_COL: Q602.2 (C), R603.2
/NOT_ARMED: U407.3 (~Q), U408.1
/NOT_AUDIO: U410.2, U417.3 (~Q), U418.1
/NRAW: C603.2, D602.2 (A), D603.2 (A), R603.1, R604.1
/OC_ADJ: R3.1, U1.7 (OC_ADJ)
/P15V: C601.1, J7.5, Q601.3 (E), R605.1, TP113.1
/P15_BASE: C602.1, D601.1 (K), Q601.1 (B), R602.2
/P15_COL: Q601.2 (C), R601.2
/PRE_IN: C109.1, J7.7, TP124.1
/PTC: J7.6, TP103.1
/PVDD: C10.1, C11.1, C12.1, C13.1, C14.1, C15.1, C301.1, C302.1, C310.1, C311.1, D301.1 (K), D302.1 (K), D303.1 (A1), J1.1, R301.1, R320.1, R601.1, R602.1, R701.1, TP111.1, U1.29 (PVDD_CD), U1.30 (PVDD_CD), U1.31 (PVDD_CD), U1.36 (PVDD_AB), U1.37 (PVDD_AB), U1.38 (PVDD_AB), U302.2 (VIN), U302.3 (EN/UVLO)
/PVDD_OV_SENSE: R321.2, R322.1, U303.4 (INB-)
/PVDD_UV_SENSE: R320.2, R321.1, U303.3 (INA+)
/PWM_AC: C16.2, C18.2, L1.1, U1.32 (OUT_C), U1.39 (OUT_A), U1.40 (OUT_A)
/PWM_BD: C17.2, C19.2, L2.2, U1.27 (OUT_D), U1.28 (OUT_D), U1.35 (OUT_B)
/RAILS_OK: Q701.1 (G), R323.2, TP122.1, U302.6 (PGOOD), U303.1 (OUTA), U303.6 (OUTB), U402.3 (~MR), U409.4, U411.4, U412.1 (OUTA), U412.6 (OUTB), U413.1 (OUTA), U413.6 (OUTB), U419.4, U504.1 (OUTA), U504.6 (OUTB)
/RAILS_QUAL: R404.2, U403.1 (~RESET), U406.6 (~CLR)
/RELAY_BASE: Q501.1 (B), R501.2, R502.1
/RELAY_DRV: D501.2 (A), D704.1 (K), K501.8, Q501.3 (C)
/RELAY_FLY: D501.1 (K), D502.1 (K)
/RESET: J4.2, Q702.1 (G), R9.1, R408.2, TP119.1, U1.18 (~RESET)
/RESET_GO: R408.1, R428.2, U414.1 (~RESET)
/RUN: R501.1, U406.5 (Q), U407.2 (D), U407.6 (~CLR), U410.1, U414.3 (~MR), U417.6 (~CLR)
/SEQ_3V3: C403.1, C406.1, C407.1, C408.1, C409.1, C410.1, C411.1, C412.1, C413.1, C414.1, C415.1, C418.1, C419.1, C420.1, C421.1, C422.1, C423.1, JP701.1, R323.1, R401.1, R402.1, R403.1, R404.1, R405.1, R406.1, R428.1, R429.1, R430.1, R715.1, R716.1, TP117.1, U401.5 (VOUT), U402.5 (SENSE), U402.6 (VDD), U403.5 (SENSE), U403.6 (VDD), U404.5 (SENSE), U404.6 (VDD), U405.5 (VCC), U406.7 (~PRE), U406.8 (VCC), U407.7 (~PRE), U407.8 (VCC), U408.5 (VCC), U409.5 (VCC), U410.5 (VCC), U411.5 (VCC), U414.5 (SENSE), U414.6 (VDD), U415.5 (VCC), U416.5 (SENSE), U416.6 (VDD), U417.2 (D), U417.7 (~PRE), U417.8 (VCC), U418.5 (VCC), U419.5 (VCC)
/SEQ_BYP: C402.1, U401.4 (BYPASS)
/SEQ_CT1: R401.2, U402.4 (CT)
/SEQ_CT2: R403.2, U403.4 (CT)
/SEQ_CT3: C404.1, U404.4 (CT)
/SEQ_HOLD1: R402.2, U402.1 (~RESET), U403.3 (~MR)
/SPK_N: C26.1, C27.1, C28.1, C29.1, J5.2, L2.1
/SPK_N_SNUB: C29.2, R6.1
/SPK_P: C22.1, C23.1, C24.1, C25.1, J5.1, L1.2
/SPK_P_SNUB: C25.2, R5.1
/START_BTN: J401.1, R406.2, R407.1
/START_DEB: C405.1, R407.2, U405.2
/START_EDGE: U405.4, U406.1 (C)
/START_TIMEOUT: R405.2, U404.1 (~RESET), U411.2
/START_WIN: U404.3 (~MR), U410.4
/STB: J7.2, TP102.1
/T1_A: D301.2 (A), D602.1 (K), J301.1
/T1_B: D302.2 (A), D603.1 (K), J301.3
/T1_CT: F301.1, J301.2, TP129.1
/U2B_PARK: U2.6 (-), U2.7
/U2_FB: R110.2, R111.1, U2.2 (-)
/VBG: C9.1, U1.20 (VBG)
/VIO_3V3_EXTERNAL: J4.1, R7.1, R8.1
/VMID: C203.1, R102.2, R111.2, R205.2, R206.1, R424.1, R426.1, TP116.1, U2.5 (+), U3.5 (+), U503.2 (S1)
/VMID_OV: R426.2, R427.1, U413.4 (INB-)
/VMID_UV: R424.2, R425.1, U413.3 (INA+)

Notes on the sheet:
SELECTED CORE - PBTL - POWER/FRONT-END NOT INCLUDED - CASE FIT UNMEASURED
D-020/D-024 DISCRETE SEQUENCER
PCB-004 TEST POINTS, STATUS LEDS, FAN OUTPUT (NO LOAD ON TPA/AUDIO NODES)
D-021 POWER: FOOTPRINTS NOT AUDITED; NEVER BRIDGE T1_A-T1_B
D-024: DRIVERS REACH TPA ONLY THROUGH RELAY K501 (iso-d019); DO NOT ENERGIZE
D-024 INPUT ISOLATION RELAY / MUTE / DC WINDOWS
D-032 OEM PREAMP/LIMITER INTERFACE: P101, +/-15 V, LIMIT FROM CLIP_OTW

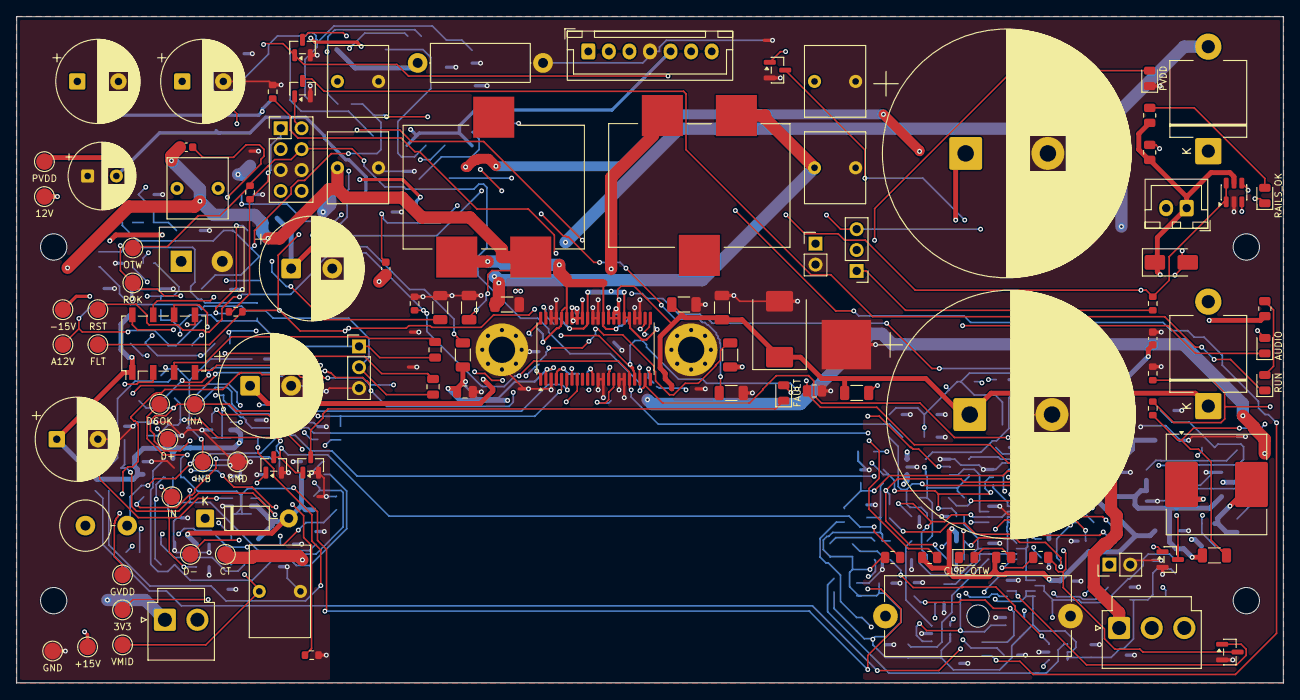
[picture p29: board system-candidate.kicad_pcb from above]

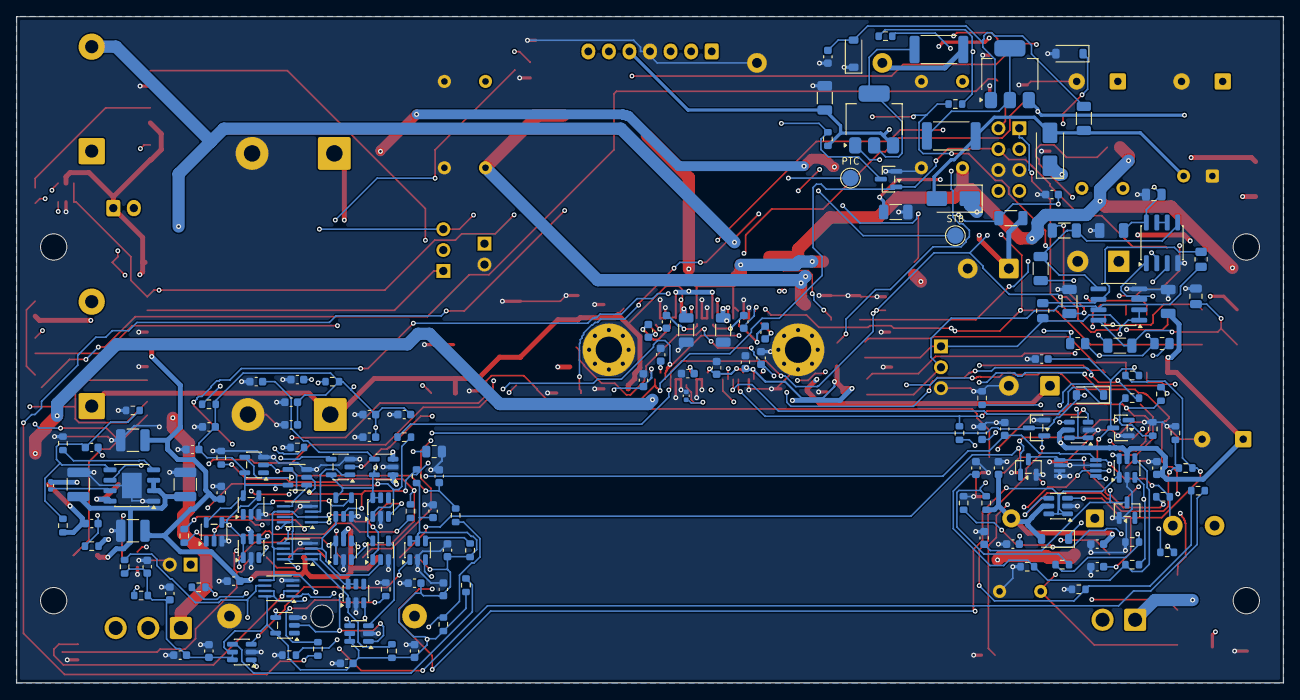
[picture p30: board system-candidate.kicad_pcb from below]

Board: 4 copper layers, 154.0 x 81.0 mm, 269 parts (158 on the bottom side), 120 nets.

Other parts of the board:
H1, H2, H3, H4: OEM L-bracket M3; MountingHole_3.2mm_M3
H5, H6: Thermal block clamp M3 (GND); MountingHole_3.2mm_M3_Pad_Via

Their connections:
/GND: H5.1, H6.1; also elsewhere on the board
