bernardopg/ps28-modern-amp/(commit log)

2026-10-08 docs: publish native KiCad 3D images and animated galleries
2026-10-08 feat(analog): evaluate physical VMID and block unsafe power-down
2026-10-08 feat(analog): protect VMID with isolated rail and passive bias
2026-10-08 fix(media): verify native schematic SVG export
2026-10-08 docs(markdown): normalize lint formatting and add markdownlint config
    - Add .markdownlint.json disabling MD013 (line length) and MD033 (inline HTML) for the long PT-BR technical docs.
    - Fix blank lines around headings and lists, indent list continuations, and wrap bare URLs in angle brackets.
    - Reformat the analog-protected SVG export and track kicad/.history as a submodule pointer.
2026-10-09 fix(media): restore native analog-protected SVG and drop stale JLCPCB export
    The markdown lint commit reformatted the KiCad SVG export, breaking the
    manifest hash check in make check. Restore the native export and mark it
    binary. Remove kicad/jlcpcb: unrouted draft A Gerbers without LCSC codes
    that could be uploaded by mistake.
2026-10-09 feat(power): adopt D-021 unregulated PVDD and D-022 adjustable crossover
    Owner measurements: T1 34.35 VAC per half at 126.6 VAC mains, CT on the
    black lead, ~0.2 ohm per half; woofer 20PR10DAG-FW06-E, Re 4.4 ohm.
    Replace the regulated 36 V buck with a two-diode CT rectifier (PVDD
    ~42-50 V) and keep the original 50-150 Hz crossover control.
    Add a 54-case ngspice sweep (make simulate-power) and an isolated
    kicad/power-d021 capture (ERC 0, MPNs TBD). TPA3255 has no PVDD OVP,
    so an external supervisor is specified but not yet captured.
2026-10-09 docs(setup): share Headroom per project and record T1 harness connector
    - Headroom MCP shared by Claude Code, Codex, Pi and Hermes on .headroom/memory.db;
    local settings and wrapper runtime state ignored.
    - T1 secondary harness: 3-way red-black-red, CT centre, matches J301;
    housing family, pitch and current rating still TBD.
    - Ignore local JLCPCB plugin output; README index links power-d021.
2026-10-09 docs(power): record T1 harness pitch and wire rating
    Pitch ~4 mm (3.96 mm family), UL AWM 1015 20 AWG 105 C 600 V; header series and per-pin rating stay TBD.
2026-10-09 feat(power): capture AUX 12 V buck and PVDD window supervisor
    - U302 LM5164DDA with TI SNVSAU4D Fig 7-1 values (12.09 V nominal,
    11.69-12.50 V worst case from VREF and 1 % feedback).
    - U303 TPS3700DDC window on PVDD: OV 50.97-52.24 V, UV 27.28-28.35 V
    worst case; local symbol from SBVS187G p.4.
    - RAILS_OK open-drain wired-AND (PGOOD, OV, UV) for D-020 rails_valid,
    not a direct RESET drive. ERC 0; footprints and some MPNs TBD.
    - build() accepts extra local symbols; fetch list adds lm5164/tps3700.
2026-10-10 feat(eda): capture discrete D-020 sequencer and integrate D-021 power into system candidate
    - seq-d020 (D-023): LP2985 3.3 V, two TPS3808 stages (>=360 ms hold),
    74LVC2G74 RUN/ARMED latches (human start edge with CLIP_OTW high, FAULT
    arming and latch with human re-arm), 0.62-1.44 s start timeout, TPS3700
    windows for ANALOG_12V and VMID on the RAILS_OK wired-AND.
    - seq_d020_logic simulates the captured netlist; mutation-checked tests.
    - system-candidate: power and seq banks outside the OEM outline, 150
    footprints, 421 native pins matched; PVDD_36V renamed PVDD; J4/R7/R8 DNP.
    ERC equal to base (4 PBTL OUT_x, 1 MONO_BIASED), DRC 0, 338 unrouted.
    - power-d021: candidate stock footprint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
2026-10-10 feat(eda): complete D-019 input interface with Form C relay, mute and DC observation
    - iso-d019 (D-024): Omron G6K-2F DC12 after C20/C21 (COM isolated plate,
    NO TPA pin, NC 1k discharge; break-before-make, isolated when unpowered),
    TMUX6219 mute DIVIDED->VMID, TPS3700 DC windows on both pins (2-5 V,
    tau ~50 ms) and AUX_RAW window, MMBT3904 relay/mute drivers.
    - seq-d020: RESET released 12-28 ms after relay command, DC dwell 12-28 ms
    before AUDIO_EN latch, DC loss trips RAILS_OK, start timeout covers dwell.
    - simulate_d019: 1350 ngspice cases, pin -0.262..6.61 V within -0.3..7 V
    (worst with pessimistic 10 ms opening; >= 0 V at datasheet 3 ms).
    - system-candidate: 200 footprints, 570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
2026-10-10 feat(eda): clamp TPA inputs against single faults and audit TMUX6219 land pattern
    - D-024a: 3.3k series after relay NO plus BAT54 (K on pin, A to GND).
    Driver shorted low with relay closed: about -5.9 V unclamped, <= -0.351 V
    at datasheet maximum VF (still 51 mV beyond -0.3 V); gain -1.33 dB typ.
    - simulate_d019: 216 single-fault cases; normal cases now -0.158..6.47 V.
    - Local TI DGK0008A footprint (SCDS420E p.50) replaces generic MSOP-8.
    - Risk table in iso-d019.md: bounce resolved by design, sub-20 Hz fails
    safe, stuck-high driver and unpowered TPA input remain open.
    - system-candidate: 204 footprints, 580 pins matched, DRC 0; gallery and
    SVG regenerated.
2026-10-10 docs(project): roadmap to production, ELEC-004 task and refreshed status
    - docs/production-roadmap.md: ordered path to JLCPCB with gates and owner inputs.
    - ELEC-004 (front-end D-022) task, sprint S03 and GitHub issue #20 mirror.
    - development-status, README, AGENTS point to the system candidate.
    - Footprints TI DGK0008A and Omron G6K-2F audited against vendor drawings.
2026-10-10 test(eda): skip capture generators when KiCad libraries are absent (CI)
2026-10-10 docs(mech): record owner heatsink and U-profile measurements for MECH-001
    Backplate, external heatsink (position, 8 holes) and U profile 65x33x30 with 35 mm anchors; sums close to 200x300 and match manual BOM within 1 mm. D-013 adapter must be L-shaped because the profile face is perpendicular to the PCB.
2026-10-10 docs(mech): main PCB length, M3 mounting holes and U-profile contact; flag ambiguous depth
2026-10-10 docs(mech): main PCB 154x81x1 mm and lateral position; one 4 mm gap discrepancy open
2026-10-10 docs(mech): resolve profile gaps with backplate edge distances (38/51 mm)
2026-10-10 docs(mech): TO-3P holes on the U-profile outer leg
2026-10-10 docs(mech): TO-3P holes are M3
2026-10-10 docs(mech): OEM harness connectors and sealing from owner photos
2026-10-10 docs(mech): harness pitches (7-way 2.5 mm, woofer 4 mm)
2026-10-10 docs(mech): 7-way harness resistance to GND
2026-10-10 docs(mech): 7-way harness 20k readings; pin 6 negative rail
2026-10-10 docs(mech): 7-way harness live voltages; original preamp runs on +/-15 V
2026-10-10 docs(mech): 7-way harness voltages vs LEVEL; pin 1 is preamp audio output
2026-10-10 docs(mech): original preamp output oscillates rail to rail with shorted inputs
2026-10-10 feat(pcb): apply measured OEM outline, M3 holes and U-profile keepout to system candidate
    154x81 mm outline, 4 board-only M3 holes and F.Cu rule area OEM_U_PROFILE replace the inferred 153x79.1 study outline. DRC now shows 34 real placement conflicts (core parts inside the profile, J5 on H3): PCB-001 worklist.
2026-10-10 feat(pcb): study placement of all 204 parts in the measured OEM outline
    Owner-confirmed orientation (x=20 relay end, x=174 transformer end). place_system_candidate.py packs power/THT on top and logic/analog SMD on the bottom; TPA3255 beside the U-profile leg. DRC: silkscreen only. README shows the latest 3D render.
2026-10-11 feat(pcb): autoroute system candidate and add datasheet envelope 3D models
    make route-system: Freerouting 1.9.0 under Xvfb, 4 layers with In1 GND plane, 463/470 connections, 242 vias, DRC without clearance/short. Seven connections (TPA fine-pitch PWM/PVDD exits and four small nets) left for manual routing. Envelope VRML models for TPA3255 DDV, JST VH, WR-TBL and M3 screws from datasheet outlines; README shows the latest render.
2026-10-11 docs(readme): reformula README como índice/wiki visual
    - Hero com render 3D da candidata de sistema (D-023) e faixa de status
    - Renders funcionais: schematics nativos KiCad embedados (sistema, D-018, LR4)
    - Navegação por área em <details> recolhíveis; detalhe textual movido para dentro
    - Sem novos assets; apenas links aos exports existentes
    - make check: 0 erros de validação, 105 testes OK
2026-10-11 chore(git): ignorar .history e remover gitlink orfao do indice
    - .gitignore: ignora .history/ (backups do KiCad)
    - remove gitlink orfao kicad/.history do indice (repo aninhado sem .gitmodules)
    - resolve marcadores de conflito de merge/stash commitados em 3412f04;
    mantem variante comentada (Upstream) preservando symlinks .claude/skills,
    .agents/skills e CLAUDE.md
    - make check: 0 erros de validacao, 105 testes OK
2026-10-12 feat(power): versionar revisão de prontidão e remediação de potência
    - make pcb-readiness: auditoria de inventário/DRC da candidata (docs/pcb-readiness-review.md)
    - kicad/power-package-review e kicad/power-researched: capturas isoladas de revisão (ERC 0)
    - análise D-028 de transientes e budget (docs/power-remediation.md)
    - medidas de folga informadas pelo proprietário (mechanical/owner-clearance-20261012.json)
    - testes unitários e relatórios em tests/reports/
    - .gitignore: logs/ de roteamento local
2026-10-12 feat(pcb): Rev A de bancada (D-029) sem bloco retificador T1
    - D-029: primeira fabricação = bring-up com PVDD de fonte de bancada via J1;
    J301/F301/D301/D302/C301/C302 adiados para Rev B após BENCH-001 medir inrush/I²t
    - scripts/create_rev_a_bench.py gera kicad/rev-a-bench/ sem alterar integrate_candidate.py
    (198 footprints, 567 pads netlist<->PCB, joins J1->U1/C14/U302 verificados)
    - ERC igual à candidata; DRC 0 geometria/0 paridade; 460 conexões não roteadas
    - place_system_candidate.py ignora âncoras ausentes
    - tasks PCB-003/PWR-001/BENCH-001 e backlog reorganizados para o caminho da Rev A
2026-10-12 feat(pcb): placa única D-030 com potência fechada e regras pragmáticas
    - revoga D-029 (Rev A/Rev B) e remove kicad/rev-a-bench
    - J301 JST B3P-VH (manual PS28 p.14), D301/D302 P600J, C301/C302 em footprint D30,
    F301 Littelfuse 02186.3MXP; R201 DIN0617 vertical
    - ERC: pinos PBTL paralelos passive e TP101 MONO_IN (de fix/pcb-route-drc-erc)
    - system-candidate regenerada: 205 footprints, ERC 0, DRC 0, paridade 0,
    471 conexões para rota manual; autoroute de estudo descartado; galeria 3D refeita
    - AGENTS.md/safety/PLANNING: política de evidência pragmática e Done objetivo
    - tasks SETUP-003, PCB-003, PWR-001, ELEC-001 e SYS-001 concluídas
    - roteiro de medidas restantes em mechanical/meas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
2026-10-12 feat(pcb): bloco térmico do TPA3255, J5 VH e medidas finais (D-031)
    - medidas do proprietário: furos M3 roscados no perfil, perfil flutuante,
    polaridade do woofer e resistências de T1 (CT no pino central)
    - placer: keepout do bloco térmico (só SMD baixo sob o bloco), J6 para trança GND
    - J5 -> JST B2P-VH (chicote original do woofer); C14/C15 -> UHE1J681MHD D12,5,
    bulk PVDD 10,76 mF
    - system-candidate regenerada: ERC 0, DRC 0, paridade 0, 471 conexões a rotear
    - MECH-001 concluída; PCB-001 em andamento; gabarito 1:1 movido para FAB-001
2026-10-13 feat(pcb): front-end OEM, placement final, bloco térmico e rota com planos
    - D-032: preamp/limiter originais via J7 (JST XH 7 vias), ±15 V discretos,
    LIMIT por CLIP_OTW, ganho U2A 1,887; LR4 onboard removido
    - placement revisado: LC junto do U1, buck sob L301, retificador do lado de T1
    - bloco térmico: cotas, STL e modelo 3D (Blender); H5/H6 M3 em GND
    - J5: modelo 3D JST B2P-VH feito no Blender
    - cobre: planos GND/PVDD, fills, fanout do U1; 2.343 trilhas, 310 vias
    - ERC 0, paridade 0; 56 conexões abertas e 4 starved_thermal pendentes
    - ELEC-002/ELEC-004 concluídas; PCB-002 em andamento; nova task PCB-004
2026-10-13 feat(pcb): test points, LEDs de status, saída de fan e nova rota (PCB-004)
    - 21 test points com nome no silk (SPK± fora), 6 LEDs: PVDD, RAILS_OK, RUN,
    AUDIO, FAULT, CLIP_OTW, só via gates de MOSFET
    - fan 12 V em J8 com AO3400A, flyback e jumper de modo (sempre/CLIP_OTW)
    - re-rota: 2.973 trilhas, 404 vias; ERC 0, paridade 0; 59 conexões abertas
    e 3 starved_thermal; removidos trechos PVDD/T1_A com isolamento 0,118 mm
    - docs/bringup.md com valores esperados por test point; PCB-001/PCB-004 Done
2026-10-13 feat(pcb): segunda passada de rota e GND sólido em pads THT
    - route_system_candidate.py --resume: mantém o cobre e liga só o que falta
    - fills GND externos com conexão sólida (sem starved_thermal)
    - 3.073 trilhas, 407 vias; ERC 0, DRC 0 violações, paridade 0
    - 58 conexões abertas (15 no U1) registradas em PCB-002
2026-10-13 feat(pcb): placement afrouxado em volta do U1 e nova rota (D-034)
    - anel livre de 3 mm ao redor do TPA3255; lógica iso/seq/dbg afastada
    - rota nova + passada --resume: 3.343 trilhas, 448 vias
    - ERC 0, DRC 0 violações, paridade 0; conexões abertas 58 -> 6
    - VMID colado à borda removido; PWM_AC 39-40 e PWM_BD 27-28 unidos no pad
2026-10-13 feat(pcb): saídas PWM do TPA3255 à mão, fechamento de conexões e make fab (D-035)
    - escapes 0,25 mm, barramentos PWM_AC (F.Cu 1,0 mm) e PWM_BD (B.Cu 0,6 mm),
    1,5 mm até L1/L2; C8 movido para B.Cu sob o U1
    - close_open_connections.py: A* em F/In2/B, aceita ligação só sem erro DRC novo
    - export_fab.py / make fab: Gerber, drill, CPL, BOM, PDF, gabarito 1:1, SHA256
    - ERC 0, DRC 0 erros, paridade 0; 9 conexões de sinal para o KiCad interativo
2026-10-16 fix(pcb): close routing and verify nominal fit
    Correct TPA placement and TP127/R506 connectivity.\nPreserve OEM fit assumptions and explicit fabrication gates.\nSync documentation, renders, tasks and GitHub mirrors.\n\nValidate ERC/DRC/parity and 138 local tests.\n\nRefs #3, #7, #8, #10, #11
2026-10-16 ci: pin Node 24 actions and stable runners
    Audit official checkout v7.0.1 and upload-artifact v7.0.2 releases. Preserve ZIP diagnostics and remove deprecated runtime warnings.
2026-10-16 fix(pcb): reconcile purchasing codes and add verified studio drafts
2026-10-16 fix(eda): align source notes and keep the whole board framed
2026-10-16 feat(bom): close remaining 190 purchase selections
2026-10-17 fix(hardware): close SYS-002 and correct capacitor derating
2026-10-17 docs: alinhar porta do proxy headroom para 8791
2026-10-17 refactor: reorganize project around the single product board
    - D-037: verify requirements by analysis/simulation/CAD; only physical steps are
    the 1:1 template check (MECH-002) and installation/first power-up (BENCH-002)
    - tasks consolidated (BUY-001 into FAB-001, BENCH-001/ACOU-001 into BENCH-002;
    TOOL-001 and PCB-003 removed); GitHub mirror updated
    - D-038: remove historical KiCad revisions, generators, superseded studies,
    OEM/core galleries and docs/archive; helpers kept in scripts/pcb_model.py
    - direct README, docs index and docs/status.md
    - Blender renders rebuilt with nominal OEM U profile, bead-blasted block,
    datasheet materials and detail view; clean KiCad gallery with block w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
2026-10-17 fix: resolve reorganization follow-ups
    - thermal block WRL fixed at source (ccw FALSE, aluminium material); KiCad
    gallery renders the model directly; thermal-fit report regenerated
    - D-039 fab spec: 4 layers 1.6 mm, ENIG, green mask
    - D-040 Rev.B1 amendment (no-bench verification) approved by owner delegation
    - Blender: light linking removes backdrop hotspot, ENIG pads, top-view exposure,
    PS28_STUDIO_VIEWS subset rendering
    - version Headroom memory block in AGENTS.md
